bglasford1/AgcBlockIIComputer/schematics/DSKY/README.md

The DSKY sub-system consists of the Keyboard, Display and IMI Interface modules. The following schematic sheets are used.

DSKY_IMI : The DSKY Interface module

DSKY_KBD : The Keyboard module

DSKY_TEST : Simple test module

DSKY_DSP : The Display module

    DSKY_DSP_CHN : Contains I/O channel registers
    
    DSKY_DSP_REGCTL : Converts channel bits 12-15 into discrete signals 

    DSKY_DSP_DCD : Contains display code converters

    DSKY_DSP_IND : Contains indicator lights logic

    DSKY_DSP_CTL : Contains display control logic

    DSKY_DSP_REG : Contains display registers
    
    DSKY_DSP_SIGN : Contains decode logic for the sign LEDs

    DSKY_DSP_DRV : Contains the LED driver chips
    
    DSKY_DSP_LCD : Contains the 7-segment LEDs
