bglasford1/AgcBlockIIComputer/schematics/DISP/README.md

The Display (DISP) sub-system consists of the Monitor and Display Interface modules. The following schematic sheets are used.

DISP_DMI : The Display Interface Module

DISP_MON : The Monitor Module

    DISP_MON_DCD : Contains the sub-sequence decoding logic

    DISP_MON_SWT : Contains the switches
    
    DISP_MON_SWB : Contains the switch bank (16 input switches)
    
    DISP_MON_LEDs : Contains the LEDs
