bglasford1/AgcBlockIIComputer/schematics/CTL/README.md

The Control (CTL) sub-system consists of the Clock, Scalar, Timing Pulse Generator, Sequence Generator, Control Pulse Matrix and CTL Interface modules.  The following schematic sheets are used.

CTL_CLK : The Clock Module

CTL_SCL : The Scalar Module

CTL_TPG : The Timing Pulse Generator Module

CTL_CMI : The Control Interface Module

CTL_CPM-A : The A portion of the Control Pulse Matrix Module

CTL_CPM-B : The B portion of the Control Pulse Matrix Module

CTL_CPM-C : The C portion of the Control Pulse Matrix Module

CTL_SEQ : The Sequence Generator Module

    CTL_SEQ_SEQA : Contains the stage and branch registers

    CTL_SEQ_SEQB : Contains the sequence register

    CTL_SEQ_DCD : Contains the sub-sequence decode logic

    CTL_SEQ_CTL : Contains various control signal generation logic
