bglasford1/AgcBlockIIComputer/schematics/PROC/README.md

The Processor (PROC) sub-system consists of the Central Registers, Arithmetic Logic Unit and PROC Interface modules. The following schematic sheets are used.

PROC_PMI : The Processor Interface Module

PROC_CRG : The Central Registers Module

    PROC_CRG_WCHN : Contains the write channel logic
    
    PROC_CRG_RCHN : Contains the read channel logic
    
    PROC_CRG_AREG : Contains the A register logic
    
    PROC_CRG_LREG : Contains the L register logic
    
    PROC_CRG_QREG : Contains the Q register logic
    
    PROC_CRG_ZREG :  Contains the Z register logic
    
PROC_ALU : The Arithmetic Logic Unit Module

    PROC_ALU_X : Contains the X register logic
    
    PROC_ALU_Y : Contains the Y register logic
    
    PROC_ALU_ADD : Contains the X/Y adder
    
    PROC_ALU_B : Contains the B register logic
    
    PROC_ALU_ALU : Contains the ALU logic
    
    PROXC_ALU_VAL : Contains write bus ORing logic
