bglasford1/AgcBlockIIComputer/Tester/README.md

The tester programs run on either an Arduino or Raspberry Pi.  The Arduino programs have a .ino extension whereas the Raspberry pi programs are .py python programs.
