bglasford1/AgcBlockIIComputer/(threads)

Thread 1 (2021-09-28):

Flashing Noun/Verb

bglasford1, 2021-09-28:
Flash the Noun/Verb values instead of the indicator light.

bglasford1, 2021-11-16:
Updated DSKY to remove the 3 LED display driver chips and replace with simpler chips, allowing for this capability.

Closed 2021-11-16.
