bglasford1/AgcBlockIIComputer/schematics/CTL/CTL_CLK.sch

## KiCad design schematics/CTL/CTL_CLK.sch (2022-07-07)

Schematic: CTL_CLK.sch

Parts:
C1, C2: 20pF
C3: 470uF
R1: 1K
R22: 5.1k
R23: 47k
R24: 6.8k
R27: 10m
R28: 22k
R29, R30: 2.2K
U1: 74LS112
U55, U65: 74LS04
U57, U58: 74LS00
U59: 4001
U60: 74LS02
U61: 74LS32
U126: 74LS08
Y1: 4 MHz XTAL

Notes on the sheet:
Clock Step
2 MHz Clock: or slow variable rate clock FCLK = 1 : free running FCLK = 2 : stepped
Clock: 4 MHz
Four Phase Non-overlapping 1 MHz Clock
1 MHz
Slow
Selects between a fast, fixed rate clock and a slow variable rate clock.
CTL-CLK: Clock Module Copyright 2021, William Glasford
Clock Ctrl
Clock Mode
Active Low
Master Reset Switch
FFA
FFB
CLK4
Clock Rate
