bglasford1/AgcBlockIIComputer/schematics/CTL/CTL_CMI.sch

## KiCad design schematics/CTL/CTL_CMI.sch (2022-07-07)

Schematic: CTL_CMI.sch

Parts:
J100, J106: Conn_02x20
J101, J103, J107: Conn_02x08
J102, J104: Conn_02x10
J203, J204: Backplane

Notes on the sheet:
To PROC
To MEM
To I/O
Write Bus
Channel Bus
CTL-CMI: Interface Copyright 2021, William Glasford
