bglasford1/AgcBlockIIComputer/schematics/CTL/CTL_CPM-A.sch

## KiCad design schematics/CTL/CTL_CPM-A.sch (2022-07-07)

Schematic: CTL_CPM-A.sch

Parts:
U14, U15, U16, U17, U18, U19, U20, U21, U22: 27C512; DIP-28_W15.24mm
U23, U24: 74LS244
U56, U74: 74LS04
U61: 74LS32
U75, U76: 74LS08
U77: 74LS20
U78: 74LS10

Notes on the sheet:
Control Pulse Matrix EPROMs: 1’s compliement logic.
EPROM 1-8
EPROM 17-24
EPROM 25-32
EPROM 33-40
EPROM 41-48
EPROM 49-56
EPROM 57-64
EPROM 9-16
EPROM 65-72
EPROM Address Bus
Note: a signal followed by an “a” means this is a partial.
ZAP
CTL-CPM-A: CPM Part A Get Pulses from Matrix Copyright 2021, William Glasford
