bglasford1/AgcBlockIIComputer/schematics/CTL/CTL_CPM-B.sch

## KiCad design schematics/CTL/CTL_CPM-B.sch (2022-07-07)

Schematic: CTL_CPM-B.sch

Parts:
U25, U26, U27, U28, U35: 74LS138
U29, U30, U33, U34: 74LS244
U31, U32: 74LS154
U80, U84, U228: 74LS11
U81, U82, U83: 74LS08
U117, U229: 74LS04

Notes on the sheet:
Write the Super-Bank Value
CTL-CPM-B : CPM Part B Expand pulses from Part A Copyright 2021, William Glasford
TODO: The DISP, INDC and RPRO may be connected to the wrong commands; RCH, WCH
