bglasford1/AgcBlockIIComputer/schematics/CTL/CTL_CPM-C.sch

## KiCad design schematics/CTL/CTL_CPM-C.sch (2022-07-07)

Schematic: CTL_CPM-C.sch

Parts:
U36: 74LS154
U37: 74LS74
U61, U86, U87, U89, U90, U122: 74LS32
U83, U88, U97, U98: 74LS08
U85: 74LS04
U91: 74LS10
U109, U125: 74LS00

Notes on the sheet:
TP12
TP11
TP6
TP4
TP7
TP10
TP1
TP3
CLREXT Register
PWR-ON
CTL-CPM-C: CPM Part C Memory Cycle Pulses Copyright 2021, William Glasford
