bglasford1/AgcBlockIIComputer/schematics/CTL/CTL_SCL.sch

## KiCad design schematics/CTL/CTL_SCL.sch (2022-07-07)

Schematic: CTL_SCL.sch

Parts:
U2, U3, U4, U5, U6, U7: 74LS161
U8, U9, U10: 74LS112
U62: 74LS04
U63: 74LS00
U64: 74LS02

Notes on the sheet:
F10
F11
F12
F13
F14
F15
F16
F17
100 Hz
12.5 Hz
0.78125 Hz
CTL-SCL: Scalar Module Copyright 2021, William Glasford
Scalar Enable
Inverted CLK1
51.2 kHz
