bglasford1/AgcBlockIIComputer/schematics/CTL/CTL_SEQ_CTL.sch

## KiCad design schematics/CTL/CTL_SEQ_CTL.sch (2022-07-07)

Schematic: CTL_SEQ_CTL.sch

Parts:
U74, U104, U117, U186: 74LS04
U78: 74LS10
U109: 74LS00
U111: 74LS02
U118, U119, U120, U121, U202: 74LS11
U122: 74LS32
U123, U204: 74LS21
U127: 74LS20
U201: 74LS27

Notes on the sheet:
CTL-SEQ-CTL: Control Logic Copyright 2021, William Glasford
