bglasford1/AgcBlockIIComputer/schematics/CTL/CTL_SEQ_DCD.sch

## KiCad design schematics/CTL/CTL_SEQ_DCD.sch (2022-07-07)

Schematic: CTL_SEQ_DCD.sch

Parts:
U61: 74LS32
U72, U116: 74LS11
U76, U113, U114: 74LS08
U110, U186: 74LS04
U111: 74LS02
U112: 74LS27
U115: 74LS00
U188, U189: 74LS244
U190: 27C128; DIP-28_W15.24mm
U191, U192, U193, U194: 74LS154

Notes on the sheet:
Sub-Sequence Bus
Sub-Sequence EPROM
CTL-SEQ-DCD: Sequence Decoding Logic Copyright 2021, William Glasford
Note: The output of these instruction indications is negative logic.
