bglasford1/AgcBlockIIComputer/schematics/CTL/CTL_SEQ_SEQA.sch

## KiCad design schematics/CTL/CTL_SEQ_SEQA.sch (2022-07-07)

Schematic: CTL_SEQ_SEQA.sch

Parts:
U38, U39, U40, U41: 74LS74
U60: 74LS02
U73: 74LS27
U85, U92, U93, U102: 74LS04
U94, U95, U96, U97, U98: 74LS08
U99, U100: 74LS32
U101: 74LS21

Notes on the sheet:
PST1 Reg
STG1 Reg
STG2 Reg
STG3 Reg
BR1 Reg
BR2 Reg
PST2 Reg
PST3 Reg
CTL-SEQ-SEQA: Stage & Branch Registers Copyright 2021, William Glasford
