bglasford1/AgcBlockIIComputer/schematics/CTL/CTL_SEQ_SEQB.sch

## KiCad design schematics/CTL/CTL_SEQ_SEQB.sch (2022-07-07)

Schematic: CTL_SEQ_SEQB.sch

Parts:
U42, U43, U44, U45: 74LS244
U46: 74LS273
U47: 74LS112
U56, U102, U103, U104: 74LS04
U58, U109: 74LS00
U64: 74LS02
U98: 74LS08
U105, U106: 74LS20
U107: 74LS10
U108: 74LS126

Notes on the sheet:
SEQ Register
Check for all 1s.
SNI Reg
CTL-SEQ-SEQB: SEQ Register Copyright 2021, William Glasford
