bglasford1/AgcBlockIIComputer/schematics/CTL/CTL_TPG.sch

## KiCad design schematics/CTL/CTL_TPG.sch (2022-07-07)

Schematic: CTL_TPG.sch

Parts:
U12: 74LS161
U13: 74LS154
U56, U65: 74LS04
U60, U67: 74LS02
U66: 74LS00
U68, U69, U70: 74LS08
U72: 74LS11
U73: 74LS27
U108: 74LS126
U122: 74LS32

Notes on the sheet:
TPG Decoded Bus
CET
NPE
CTL-TPG: Timing Pulse Generator Copyright 2021, William Glasford
TPG Bus
Internal TPG Bus
Breakpoint Enabled
Counter Breakpoint Enabled
Interrupt Breakpoint Enabled
Exec. Mode
Execute Control
Exec. Step
Clock Mode
Standby
STBY
PWON
SRLSE
WAIT
TP12
