bglasford1/AgcBlockIIComputer/schematics/DISP/DISP_DMI.sch

## KiCad design schematics/DISP/DISP_DMI.sch (2021-08-23)

Schematic: DISP_DMI.sch

Parts:
J101: Conn_02x08
J104: Conn_02x10
J200, J201: Conn_01x40_Male

Notes on the sheet:
Switches:
Inputs: Note that very few are shown.
DISP_DMI: Interface Copyright 2021, William Glasford
Channel Bus
Write Bus
