bglasford1/AgcBlockIIComputer/schematics/DISP/DISP_MON_DCD.sch

## KiCad design schematics/DISP/DISP_MON_DCD.sch (2021-08-23)

Schematic: DISP_MON_DCD.sch

Parts:
C1, C3: .01uF
C2: 22uF
C4: 2.2uF
R86, R89: 10k
R87: 330
R88: 1k
R90: 33k
R91: 5.6k
U5, U6: LM555; SOIC-8_3.9x4.9mm_P1.27mm
U186: 74LS04
U191, U192, U193, U194: 74LS154
U206: 74LS00

Notes on the sheet:
Sub-Sequence Bus
DISP_MON_DCD: Sequence Decoding Logic Copyright 2021, William Glasford
Switch Debounce
Variable Clock Rate Dial
Clock Rate
