bglasford1/AgcBlockIIComputer/schematics/DISP/DISP_MON_SWB.sch

## KiCad design schematics/DISP/DISP_MON_SWB.sch (2021-08-11)

Schematic: DISP_MON_SWB.sch

Parts:
R1, R2, R3, R4, R5, R6, R7, R8, R9, R10, R11, R12, R13, R14, R15, R16: 1k
SW1, SW2, SW3, SW4, SW5, SW6, SW7, SW8, SW9, SW10, SW11, SW12, SW13, SW14, SW15, SW16: SW_SPDT

Notes on the sheet:
DISP_MON_SWB: Switch Bank Copyright 2021, William Glasford
