bglasford1/AgcBlockIIComputer/schematics/DISP/DISP_MON_SWT.sch

## KiCad design schematics/DISP/DISP_MON_SWT.sch (2021-08-23)

Schematic: DISP_MON_SWT.sch

Parts:
D105: LED
R17, R18, R19, R20, R21, R74, R75, R76, R77, R78, R79, R81, R82, R83, R84, R85: 1k
R80: 5.6k
R123: 470 Ohm
SW17, SW18, SW19, SW20, SW21, SW22, SW23, SW26, SW27, SW28, SW29, SW30, SW36, SW39, SW41: SW_Push
SW24, SW25, SW32, SW33, SW34, SW35, SW38, SW40: SW_SPDT
SW31, SW37: SW_Push_SPDT
U8: 74LS04
U9, U10, U11: 74LS112

Notes on the sheet:
Exec Step
Clock Step
Clock Mode (Run/Step)
SCALAR ENABLE
Enable
Disable
Exec Control
Exec Mode (Run/Step)
Breakpoint Enabled
DISP_MON_SWT: Monitor Switches Copyright 2021, William Glasford
RUPT3
RUPT4
Inc. Time1
Inc. Time3
Inc. Time4
Examine Next
Memory Read/Write
Load Memory
Examine Memory
Memory Authority
Manual
AGC
Clear Parity Alarm
Write
Read
Clock Control
Slow
1 MHz
F17x Signal
F13x Signal
F10x Signal
Master Reset
Inc. Time2
RUPT5
