bglasford1/AgcBlockIIComputer/schematics/DSKY/DSKY-DSP-CHN.sch

## KiCad design schematics/DSKY/DSKY-DSP-CHN.sch (2022-04-18)

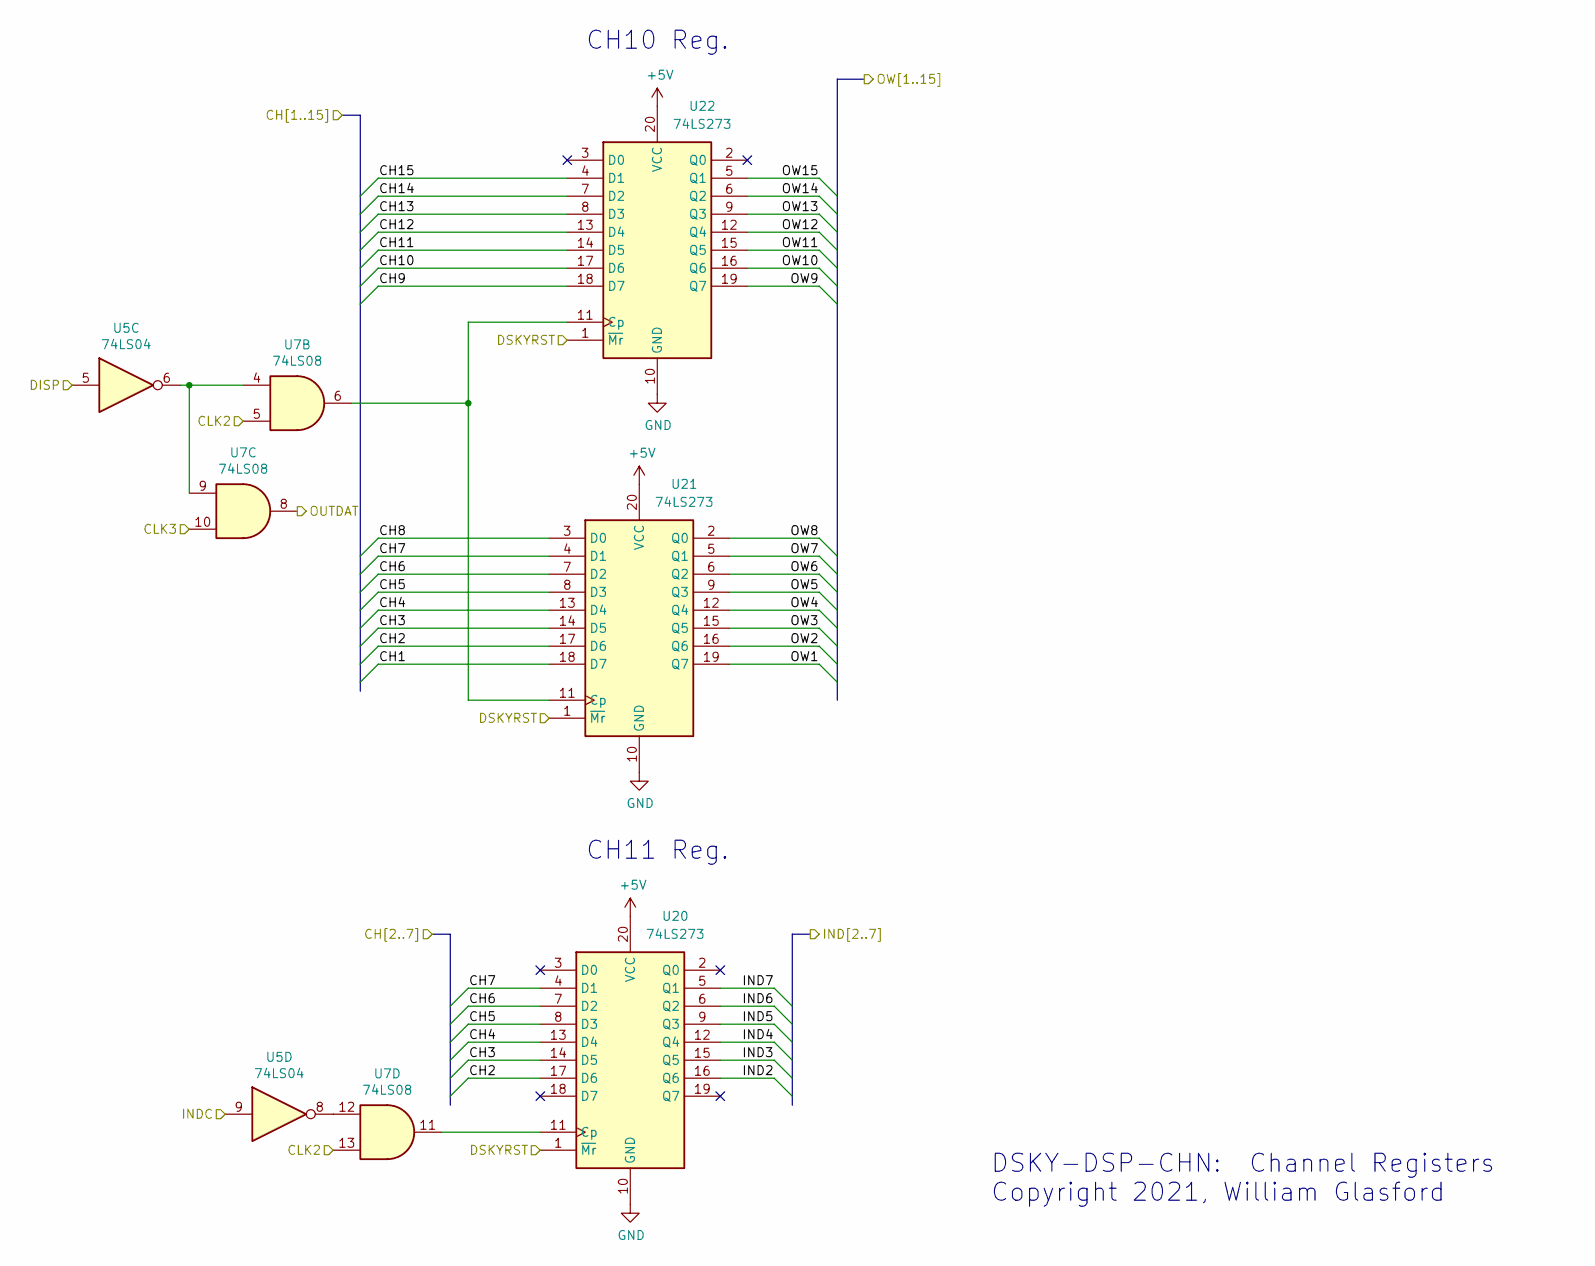
[picture p2: schematic DSKY-DSP-CHN.sch]

Parts:
U5: 74LS04
U7: 74LS08
U20, U21, U22: 74LS273

Connections:
+5V: U20.20 (VCC), U21.20 (VCC), U22.20 (VCC)
CH1: U21.18 (D7)
CH2: U20.17 (D6), U21.17 (D6)
CH3: U20.14 (D5), U21.14 (D5)
CH4: U20.13 (D4), U21.13 (D4)
CH5: U20.8 (D3), U21.8 (D3)
CH6: U20.7 (D2), U21.7 (D2)
CH7: U20.4 (D1), U21.4 (D1)
CH8: U21.3 (D0)
CH9: U22.18 (D7)
CH10: U22.17 (D6)
CH11: U22.14 (D5)
CH12: U22.13 (D4)
CH13: U22.8 (D3)
CH14: U22.7 (D2)
CH15: U22.4 (D1)
CLK2: U7.5, U7.13
CLK3: U7.10
DISP: U5.5
DSKYRST: U20.1 (~Mr), U21.1 (~Mr), U22.1 (~Mr)
GND: U20.10 (GND), U21.10 (GND), U22.10 (GND)
IND2: U20.16 (Q6)
IND3: U20.15 (Q5)
IND4: U20.12 (Q4)
IND5: U20.9 (Q3)
IND6: U20.6 (Q2)
IND7: U20.5 (Q1)
INDC: U5.9
unnamed: U5.6, U7.4, U7.9
unnamed: U5.8, U7.12
unnamed: U7.11, U20.11 (Cp)
unnamed: U7.6, U21.11 (Cp), U22.11 (Cp)
OUTDAT: U7.8
OW1: U21.19 (Q7)
OW2: U21.16 (Q6)
OW3: U21.15 (Q5)
OW4: U21.12 (Q4)
OW5: U21.9 (Q3)
OW6: U21.6 (Q2)
OW7: U21.5 (Q1)
OW8: U21.2 (Q0)
OW9: U22.19 (Q7)
OW10: U22.16 (Q6)
OW11: U22.15 (Q5)
OW12: U22.12 (Q4)
OW13: U22.9 (Q3)
OW14: U22.6 (Q2)
OW15: U22.5 (Q1)

Notes on the sheet:
CH10 Reg.
CH11 Reg.
DSKY-DSP-CHN: Channel Registers Copyright 2021, William Glasford
