bglasford1/AgcBlockIIComputer/schematics/DSKY/DSKY-DSP-REGCTL.sch

## KiCad design schematics/DSKY/DSKY-DSP-REGCTL.sch (2022-04-18)

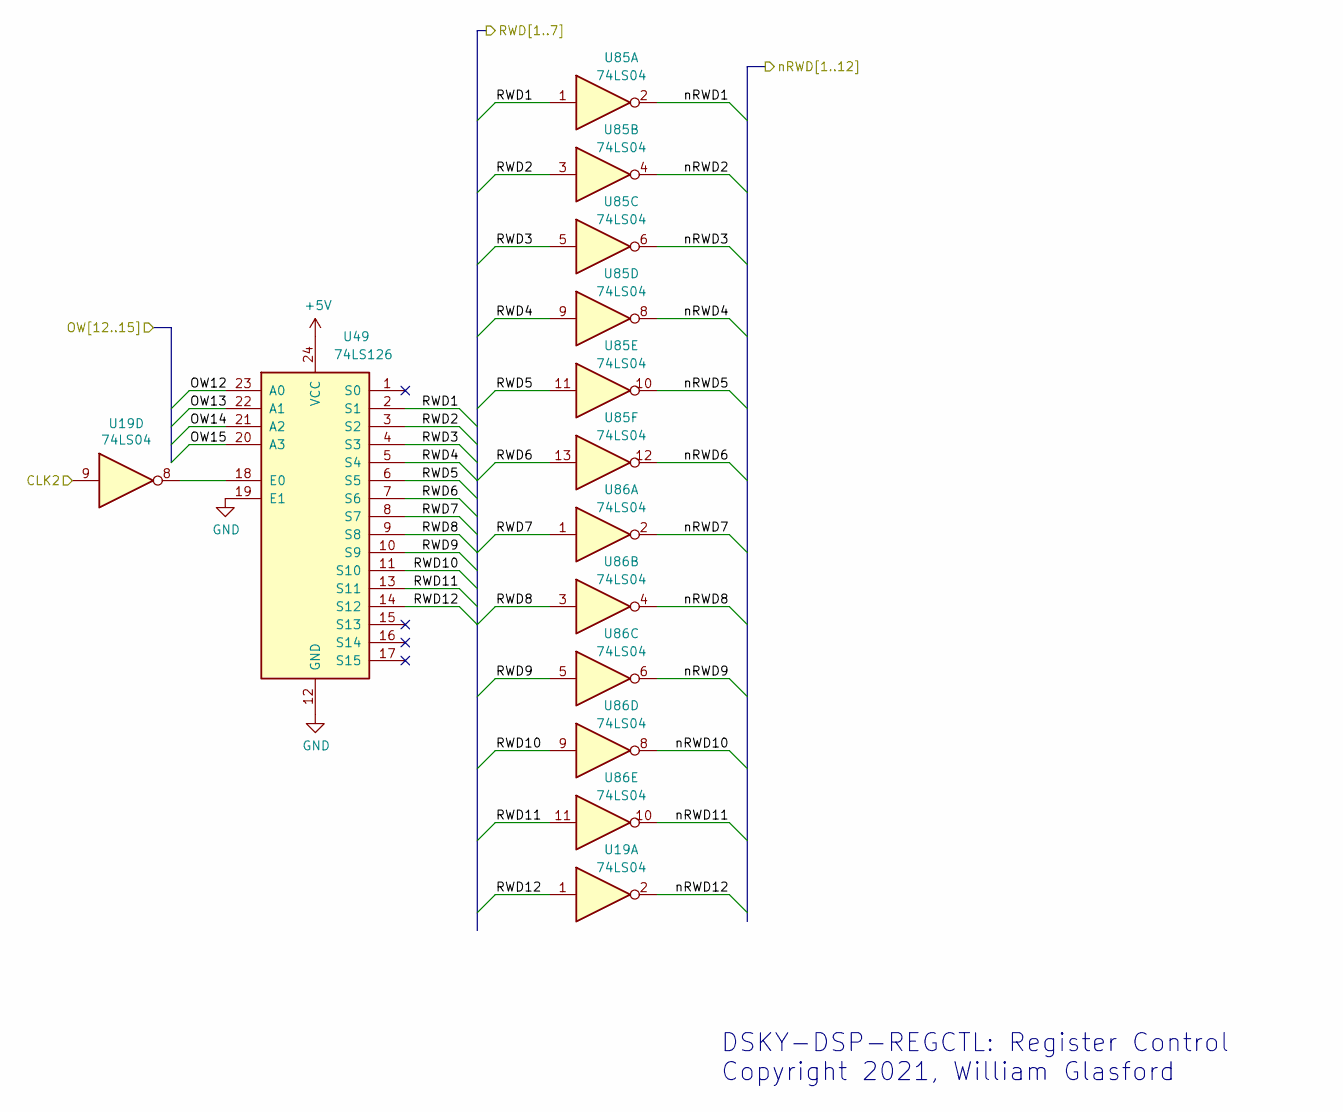
[picture p3: schematic DSKY-DSP-REGCTL.sch]

Parts:
U19, U85, U86: 74LS04
U49: 74LS126

Connections:
+5V: U49.24 (VCC)
CLK2: U19.9
GND: U49.12 (GND), U49.19 (E1)
unnamed: U19.8, U49.18 (E0)
OW12: U49.23 (A0)
OW13: U49.22 (A1)
OW14: U49.21 (A2)
OW15: U49.20 (A3)
RWD1: U49.2 (S1), U85.1
RWD2: U49.3 (S2), U85.3
RWD3: U49.4 (S3), U85.5
RWD4: U49.5 (S4), U85.9
RWD5: U49.6 (S5), U85.11
RWD6: U49.7 (S6), U85.13
RWD7: U49.8 (S7), U86.1
RWD8: U49.9 (S8), U86.3
RWD9: U49.10 (S9), U86.5
RWD10: U49.11 (S10), U86.9
RWD11: U49.13 (S11), U86.11
RWD12: U19.1, U49.14 (S12)
nRWD1: U85.2
nRWD2: U85.4
nRWD3: U85.6
nRWD4: U85.8
nRWD5: U85.10
nRWD6: U85.12
nRWD7: U86.2
nRWD8: U86.4
nRWD9: U86.6
nRWD10: U86.8
nRWD11: U86.10
nRWD12: U19.2

Notes on the sheet:
DSKY-DSP-REGCTL: Register Control Copyright 2021, William Glasford
