bglasford1/AgcBlockIIComputer/schematics/DSKY/DSKY-DSP-SIGN.sch

## KiCad design schematics/DSKY/DSKY-DSP-SIGN.sch (2022-04-18)

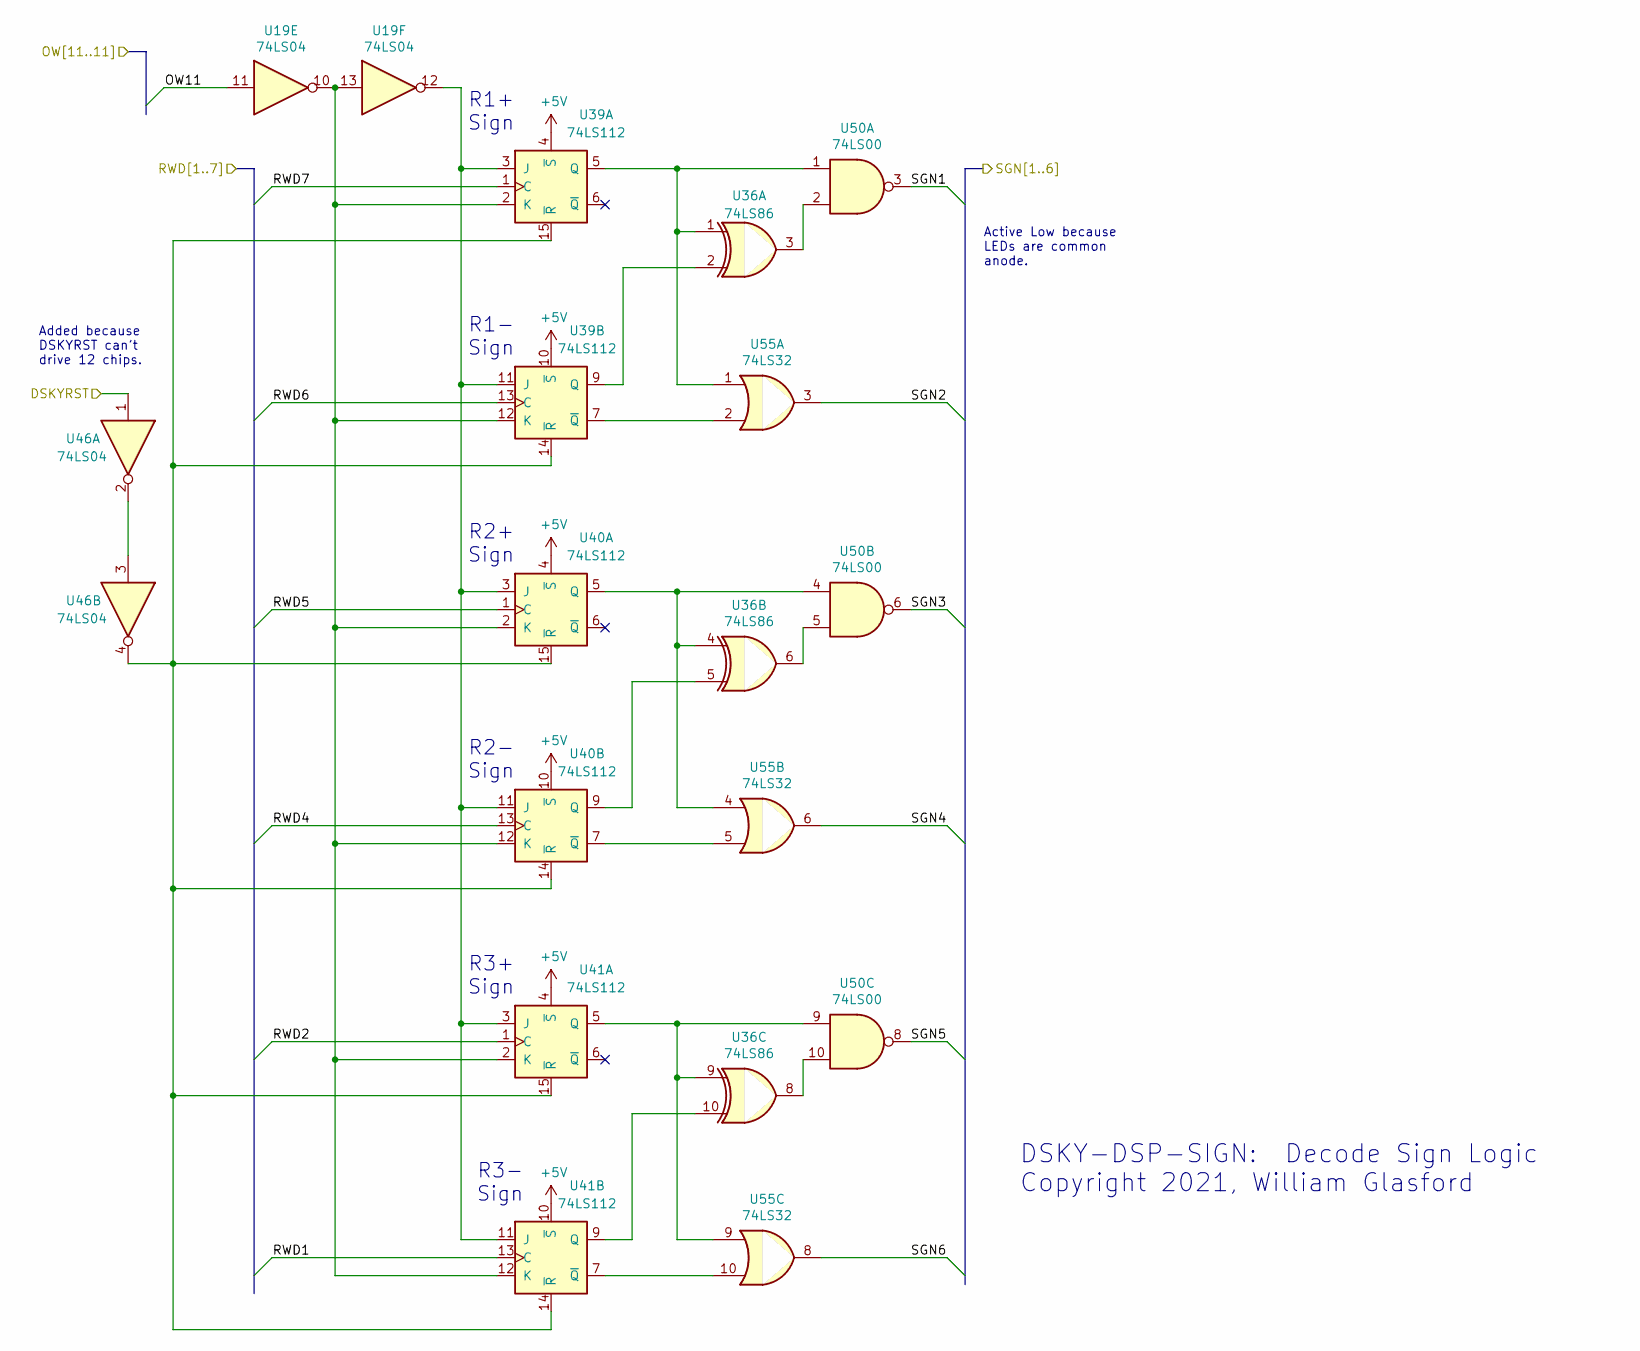
[picture p4: schematic DSKY-DSP-SIGN.sch]

Parts:
U19, U46: 74LS04
U36: 74LS86
U39, U40, U41: 74LS112
U50: 74LS00
U55: 74LS32

Connections:
+5V: U39.4 (~S), U39.10 (~S), U40.4 (~S), U40.10 (~S), U41.4 (~S), U41.10 (~S)
DSKYRST: U46.1
unnamed: U19.10, U19.13, U39.2 (K), U39.12 (K), U40.2 (K), U40.12 (K), U41.2 (K), U41.12 (K)
unnamed: U19.12, U39.3 (J), U39.11 (J), U40.3 (J), U40.11 (J), U41.3 (J), U41.11 (J)
unnamed: U36.1, U39.5 (Q), U50.1, U55.1
unnamed: U36.2, U39.9 (Q)
unnamed: U36.3, U50.2
unnamed: U36.4, U40.5 (Q), U50.4, U55.4
unnamed: U36.5, U40.9 (Q)
unnamed: U36.6, U50.5
unnamed: U36.8, U50.10
unnamed: U36.9, U41.5 (Q), U50.9, U55.9
unnamed: U36.10, U41.9 (Q)
unnamed: U39.7 (~Q), U55.2
unnamed: U39.14 (~R), U39.15 (~R), U40.14 (~R), U40.15 (~R), U41.14 (~R), U41.15 (~R), U46.4
unnamed: U40.7 (~Q), U55.5
unnamed: U41.7 (~Q), U55.10
unnamed: U46.2, U46.3
OW11: U19.11
RWD1: U41.13 (C)
RWD2: U41.1 (C)
RWD4: U40.13 (C)
RWD5: U40.1 (C)
RWD6: U39.13 (C)
RWD7: U39.1 (C)
SGN1: U50.3
SGN2: U55.3
SGN3: U50.6
SGN4: U55.6
SGN5: U50.8
SGN6: U55.8

Notes on the sheet:
DSKY-DSP-SIGN: Decode Sign Logic Copyright 2021, William Glasford
R1+ Sign
R1- Sign
R2+ Sign
R2- Sign
R3+ Sign
R3- Sign
Added because DSKYRST can’t drive 12 chips.
Active Low because LEDs are common anode.
