bglasford1/AgcBlockIIComputer/schematics/DSKY/DSKY-IMI.sch

## KiCad design schematics/DSKY/DSKY-IMI.sch (2022-04-18)

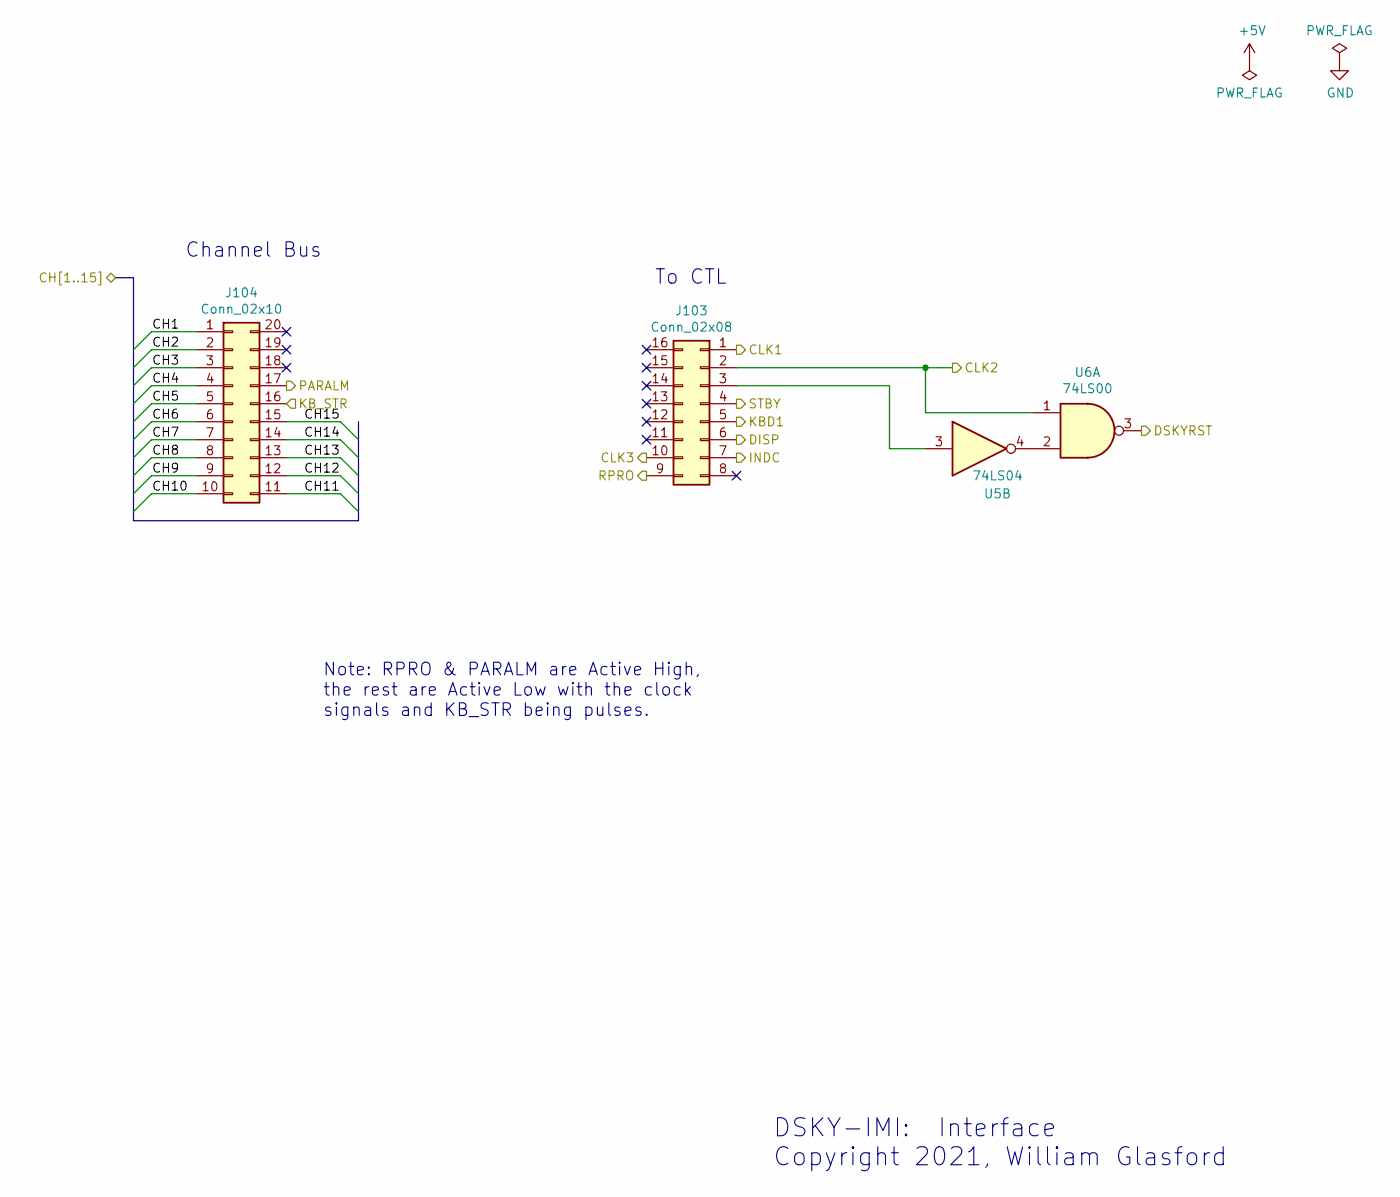
[picture p5: schematic DSKY-IMI.sch]

Parts:
J103: Conn_02x08
J104: Conn_02x10
U5: 74LS04
U6: 74LS00

Connections:
CH1: J104.1
CH2: J104.2
CH3: J104.3
CH4: J104.4
CH5: J104.5
CH6: J104.6
CH7: J104.7
CH8: J104.8
CH9: J104.9
CH10: J104.10
CH11: J104.11
CH12: J104.12
CH13: J104.13
CH14: J104.14
CH15: J104.15
CLK1: J103.1
CLK2: J103.2, U6.1
CLK3: J103.10
DISP: J103.6
DSKYRST: U6.3
INDC: J103.7
KBD1: J103.5
KB_STR: J104.16
unnamed: J103.3, U5.3
unnamed: U5.4, U6.2
PARALM: J104.17
RPRO: J103.9
STBY: J103.4

Notes on the sheet:
Channel Bus
To CTL
DSKY-IMI: Interface Copyright 2021, William Glasford
Note: RPRO & PARALM are Active High, the rest are Active Low with the clock signals and KB_STR being pulses.
