bglasford1/AgcBlockIIComputer/schematics/DSKY/DSKY-KBD.sch

## KiCad design schematics/DSKY/DSKY-KBD.sch (2022-04-18)

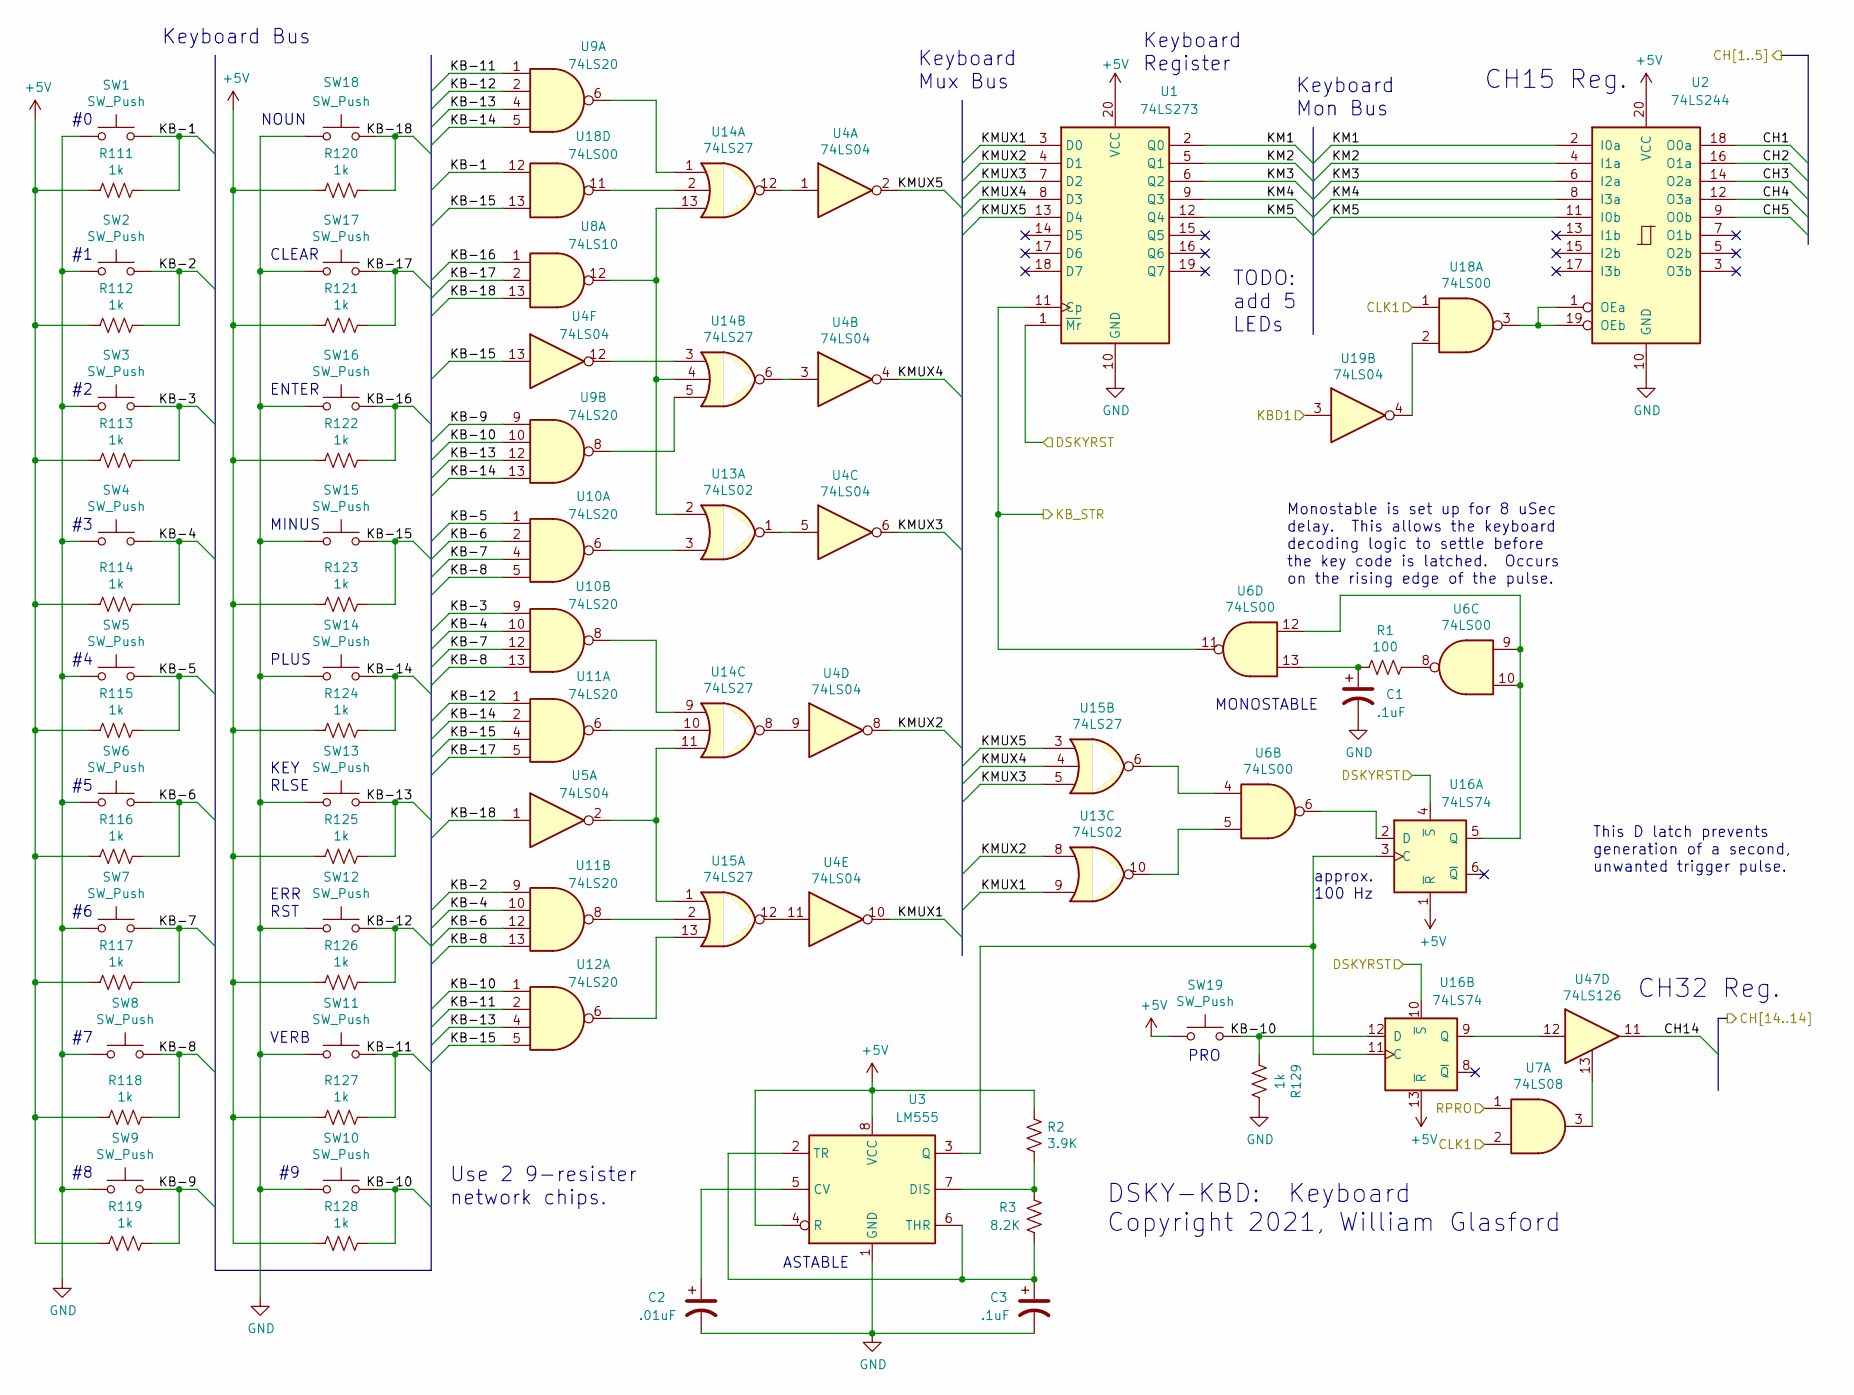
[picture p6: schematic DSKY-KBD.sch]

Parts:
C1, C3: .1uF
C2: .01uF
R1: 100
R2: 3.9K
R3: 8.2K
R111, R112, R113, R114, R115, R116, R117, R118, R119, R120, R121, R122, R123, R124, R125, R126, R127, R128, R129: 1k
SW1, SW2, SW3, SW4, SW5, SW6, SW7, SW8, SW9, SW10, SW11, SW12, SW13, SW14, SW15, SW16, SW17, SW18, SW19: SW_Push
U1: 74LS273
U2: 74LS244
U3: LM555; DIP-8_W7.62mm
U4, U5, U19: 74LS04
U6, U18: 74LS00
U7: 74LS08
U8: 74LS10
U9, U10, U11, U12: 74LS20
U13: 74LS02
U14, U15: 74LS27
U16: 74LS74
U47: 74LS126

Connections:
+5V: R2.1, R111.1, R112.1, R113.1, R114.1, R115.1, R116.1, R117.1, R118.1, R119.1, R120.1, R121.1, R122.1, R123.1, R124.1, R125.1, R126.1, R127.1, R128.1, SW19.1, U1.20 (VCC), U2.20 (VCC), U3.4 (R), U3.8 (VCC), U16.1 (~R), U16.13 (~R)
CH1: U2.18 (O0a)
CH2: U2.16 (O1a)
CH3: U2.14 (O2a)
CH4: U2.12 (O3a)
CH5: U2.9 (O0b)
CH14: U47.11
CLK1: U7.2, U18.1
DSKYRST: U1.1 (~Mr), U16.4 (~S), U16.10 (~S)
GND: C1.2, C2.2, C3.2, R129.2, SW1.1, SW2.1, SW3.1, SW4.1, SW5.1, SW6.1, SW7.1, SW8.1, SW9.1, SW10.1, SW11.1, SW12.1, SW13.1, SW14.1, SW15.1, SW16.1, SW17.1, SW18.1, U1.10 (GND), U2.10 (GND), U3.1 (GND)
KB-1: R111.2, SW1.2, U18.12
KB-2: R112.2, SW2.2, U11.9
KB-3: R113.2, SW3.2, U10.9
KB-4: R114.2, SW4.2, U10.10, U11.10
KB-5: R115.2, SW5.2, U10.1
KB-6: R116.2, SW6.2, U10.2, U11.12
KB-7: R117.2, SW7.2, U10.4, U10.12
KB-8: R118.2, SW8.2, U10.5, U10.13, U11.13
KB-9: R119.2, SW9.2, U9.9
KB-10: R128.2, R129.1, SW10.2, SW19.2, U9.10, U12.1, U16.12 (D)
KB-11: R127.2, SW11.2, U9.1, U12.2
KB-12: R126.2, SW12.2, U9.2, U11.1
KB-13: R125.2, SW13.2, U9.4, U9.12, U12.4
KB-14: R124.2, SW14.2, U9.5, U9.13, U11.2
KB-15: R123.2, SW15.2, U4.13, U11.4, U12.5, U18.13
KB-16: R122.2, SW16.2, U8.1
KB-17: R121.2, SW17.2, U8.2, U11.5
KB-18: R120.2, SW18.2, U5.1, U8.13
KBD1: U19.3
KB_STR: U1.11 (Cp), U6.11
KM1: U1.2 (Q0), U2.2 (I0a)
KM2: U1.5 (Q1), U2.4 (I1a)
KM3: U1.6 (Q2), U2.6 (I2a)
KM4: U1.9 (Q3), U2.8 (I3a)
KM5: U1.12 (Q4), U2.11 (I0b)
KMUX1: U1.3 (D0), U4.10, U13.9
KMUX2: U1.4 (D1), U4.8, U13.8
KMUX3: U1.7 (D2), U4.6, U15.5
KMUX4: U1.8 (D3), U4.4, U15.4
KMUX5: U1.13 (D4), U4.2, U15.3
unnamed: C1.1, R1.1, U6.13
unnamed: C2.1, U3.5 (CV)
unnamed: C3.1, R3.2, U3.2 (TR), U3.6 (THR)
unnamed: R1.2, U6.8
unnamed: R2.2, R3.1, U3.7 (DIS)
unnamed: U10.6, U13.3
unnamed: U10.8, U14.9
unnamed: U11.6, U14.10
unnamed: U11.8, U15.2
unnamed: U12.6, U15.13
unnamed: U4.5, U13.1
unnamed: U8.12, U13.2, U14.4, U14.13
unnamed: U6.5, U13.10
unnamed: U9.6, U14.1
unnamed: U14.2, U18.11
unnamed: U4.12, U14.3
unnamed: U9.8, U14.5
unnamed: U4.3, U14.6
unnamed: U4.9, U14.8
unnamed: U5.2, U14.11, U15.1
unnamed: U4.1, U14.12
unnamed: U6.4, U15.6
unnamed: U4.11, U15.12
unnamed: U6.6, U16.2 (D)
unnamed: U6.9, U6.10, U6.12, U16.5 (Q)
unnamed: U16.9 (Q), U47.12
unnamed: U3.3 (Q), U16.3 (C), U16.11 (C)
unnamed: U18.2, U19.4
unnamed: U2.1 (OEa), U2.19 (OEb), U18.3
unnamed: U7.3, U47.13
RPRO: U7.1

Notes on the sheet:
Keyboard Bus
Keyboard Mux Bus
Keyboard Register
NOUN
CLEAR
ENTER
MINUS
PLUS
KEY RLSE
ERR RST
VERB
This D latch prevents generation of a second, unwanted trigger pulse.
ASTABLE
approx. 100 Hz
MONOSTABLE
Monostable is set up for 8 uSec delay. This allows the keyboard decoding logic to settle before the key code is latched. Occurs on the rising edge of the pulse.
CH15 Reg.
Keyboard Mon Bus
TODO: add 5 LEDs
CH32 Reg.
DSKY-KBD: Keyboard Copyright 2021, William Glasford
Use 2 9-resister network chips.
PRO
