bglasford1/AgcBlockIIComputer/schematics/DSKY/DSKY-TEST.sch

## KiCad design schematics/DSKY/DSKY-TEST.sch (2022-04-18)

Schematic: DSKY-TEST.sch

Parts:
J203: Conn_02x08
J204: Conn_02x10
J300: RPI_Connector
U87, U88, U89, U90, U91: 74LS245

Notes on the sheet:
DSKY-TEST: Raspberry PI I/F Copyright 2021, William Glasford
