bglasford1/AgcBlockIIComputer/schematics/DSKY/DSKY_DSP_CTL.sch

## KiCad design schematics/DSKY/DSKY_DSP_CTL.sch (2022-04-18)

Schematic: DSKY_DSP_CTL.sch

Parts:
C4, C6: .01uF
C5: .001uF
C7: 22uF
R4: 3.3K
R5: 500K
R12: 27K
RV1: 10K
U17: 74LS04
U38, U75: 74LS74
U40, U41: LM555; DIP-8_W7.62mm
U48: 74LS00
U54, U81: 74LS08
U68, U80: 74LS112
U69: 74LS161
U70: 74LS154
U72: 74LS02
U73, U79: 74LS10
U74: 74LS244
U77: 74LS30
U78: 74LS27

Notes on the sheet:
2 Hz
2 KHz
DSKY-DSP-CTL: Display Control Copyright 2021, William Glasford Board #2
Mode/ Data
5th Digit: Delay one pulse off TC (1111)
State: 10000 Stop counting
Start State: 11110
State: 11111
Mode needs to be a single pulse before the write pulses to cause a read of the control data.
Write
Note: The NOR gates could be replaced by a NOT and OR gate. This was done to reduce the chip count.
