bglasford1/AgcBlockIIComputer/schematics/DSKY/DSKY_DSP_DCD.sch

## KiCad design schematics/DSKY/DSKY_DSP_DCD.sch (2022-04-18)

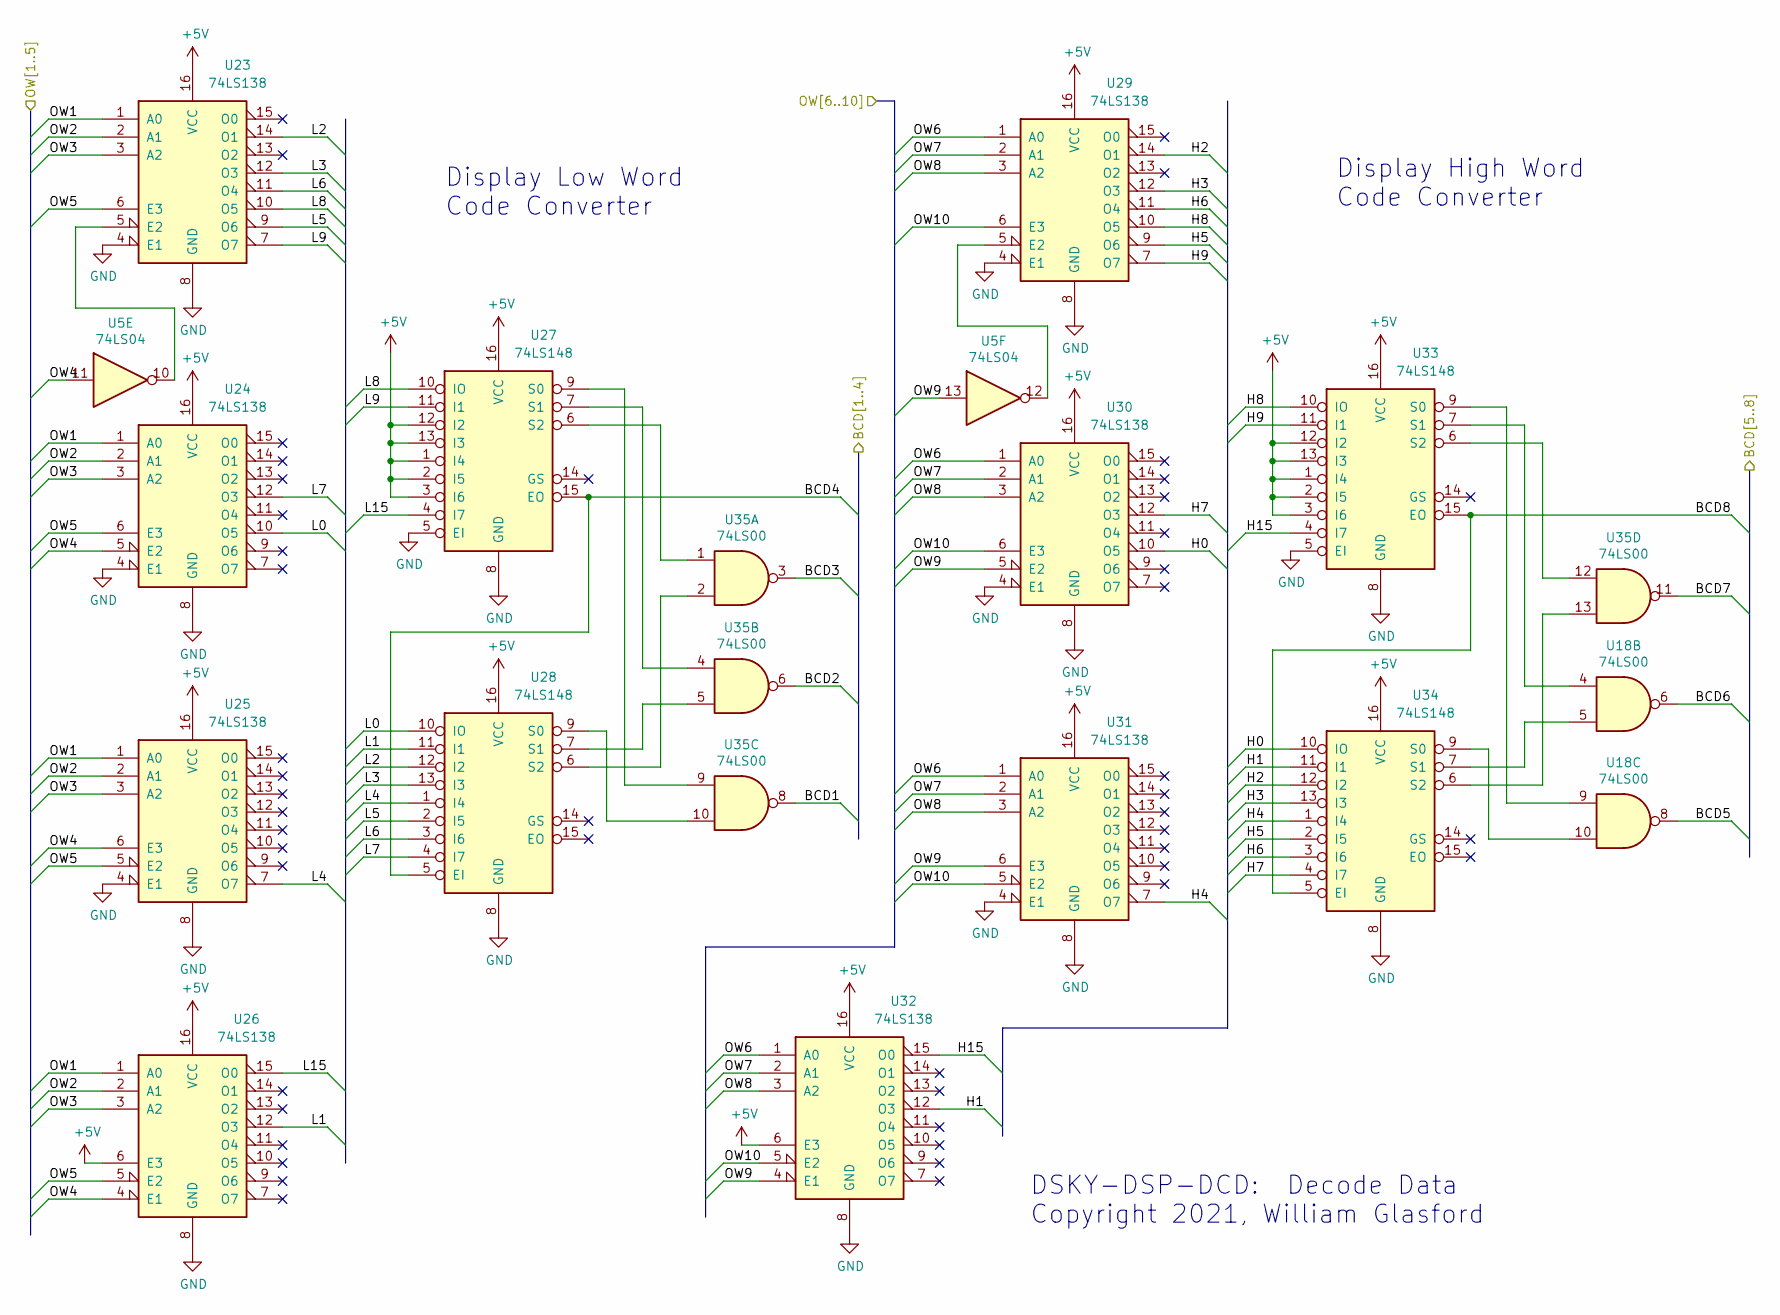
[picture p7: schematic DSKY_DSP_DCD.sch]

Parts:
U5: 74LS04
U18, U35: 74LS00
U23, U24, U25, U26, U29, U30, U31, U32: 74LS138
U27, U28, U33, U34: 74LS148

Connections:
+5V: U23.16 (VCC), U24.16 (VCC), U25.16 (VCC), U26.6 (E3), U26.16 (VCC), U27.1 (I4), U27.2 (I5), U27.3 (I6), U27.12 (I2), U27.13 (I3), U27.16 (VCC), U28.16 (VCC), U29.16 (VCC), U30.16 (VCC), U31.16 (VCC), U32.6 (E3), U32.16 (VCC), U33.1 (I4), U33.2 (I5), U33.3 (I6), U33.12 (I2), U33.13 (I3), U33.16 (VCC), U34.16 (VCC)
BCD1: U35.8
BCD2: U35.6
BCD3: U35.3
BCD4: U27.15 (EO), U28.5 (EI)
BCD5: U18.8
BCD6: U18.6
BCD7: U35.11
BCD8: U33.15 (EO), U34.5 (EI)
GND: U23.4 (E1), U23.8 (GND), U24.4 (E1), U24.8 (GND), U25.4 (E1), U25.8 (GND), U26.8 (GND), U27.5 (EI), U27.8 (GND), U28.8 (GND), U29.4 (E1), U29.8 (GND), U30.4 (E1), U30.8 (GND), U31.4 (E1), U31.8 (GND), U32.8 (GND), U33.5 (EI), U33.8 (GND), U34.8 (GND)
H0: U30.10 (O5), U34.10 (IO)
H1: U32.12 (O3), U34.11 (I1)
H2: U29.14 (O1), U34.12 (I2)
H3: U29.12 (O3), U34.13 (I3)
H4: U31.7 (O7), U34.1 (I4)
H5: U29.9 (O6), U34.2 (I5)
H6: U29.11 (O4), U34.3 (I6)
H7: U30.12 (O3), U34.4 (I7)
H8: U29.10 (O5), U33.10 (IO)
H9: U29.7 (O7), U33.11 (I1)
H15: U32.15 (O0), U33.4 (I7)
L0: U24.10 (O5), U28.10 (IO)
L1: U26.12 (O3), U28.11 (I1)
L2: U23.14 (O1), U28.12 (I2)
L3: U23.12 (O3), U28.13 (I3)
L4: U25.7 (O7), U28.1 (I4)
L5: U23.9 (O6), U28.2 (I5)
L6: U23.11 (O4), U28.3 (I6)
L7: U24.12 (O3), U28.4 (I7)
L8: U23.10 (O5), U27.10 (IO)
L9: U23.7 (O7), U27.11 (I1)
L15: U26.15 (O0), U27.4 (I7)
unnamed: U18.4, U33.7 (S1)
unnamed: U18.5, U34.7 (S1)
unnamed: U18.9, U33.9 (S0)
unnamed: U18.10, U34.9 (S0)
unnamed: U5.10, U23.5 (E2)
unnamed: U27.6 (S2), U35.1
unnamed: U27.7 (S1), U35.4
unnamed: U27.9 (S0), U35.9
unnamed: U28.6 (S2), U35.2
unnamed: U28.7 (S1), U35.5
unnamed: U28.9 (S0), U35.10
unnamed: U5.12, U29.5 (E2)
unnamed: U33.6 (S2), U35.12
unnamed: U34.6 (S2), U35.13
OW1: U23.1 (A0), U24.1 (A0), U25.1 (A0), U26.1 (A0)
OW2: U23.2 (A1), U24.2 (A1), U25.2 (A1), U26.2 (A1)
OW3: U23.3 (A2), U24.3 (A2), U25.3 (A2), U26.3 (A2)
OW4: U5.11, U24.5 (E2), U25.6 (E3), U26.4 (E1)
OW5: U23.6 (E3), U24.6 (E3), U25.5 (E2), U26.5 (E2)
OW6: U29.1 (A0), U30.1 (A0), U31.1 (A0), U32.1 (A0)
OW7: U29.2 (A1), U30.2 (A1), U31.2 (A1), U32.2 (A1)
OW8: U29.3 (A2), U30.3 (A2), U31.3 (A2), U32.3 (A2)
OW9: U5.13, U30.5 (E2), U31.6 (E3), U32.4 (E1)
OW10: U29.6 (E3), U30.6 (E3), U31.5 (E2), U32.5 (E2)

Notes on the sheet:
Display High Word Code Converter
DSKY-DSP-DCD: Decode Data Copyright 2021, William Glasford
Display Low Word Code Converter
