bglasford1/AgcBlockIIComputer/schematics/DSKY/DSKY_DSP_DRV.sch

## KiCad design schematics/DSKY/DSKY_DSP_DRV.sch (2022-04-18)

Schematic: DSKY_DSP_DRV.sch

Parts:
U42, U43, U44, U45: ICM7218A
U76: 74LS08

Notes on the sheet:
DSKY-DSP-DRV: Driver Logic Copyright 2021, William Glasford Board #2
Decoder1
Decoder2
Decoder3
Decoder4
