bglasford1/AgcBlockIIComputer/schematics/DSKY/DSKY_DSP_IND.sch

## KiCad design schematics/DSKY/DSKY_DSP_IND.sch (2022-04-18)

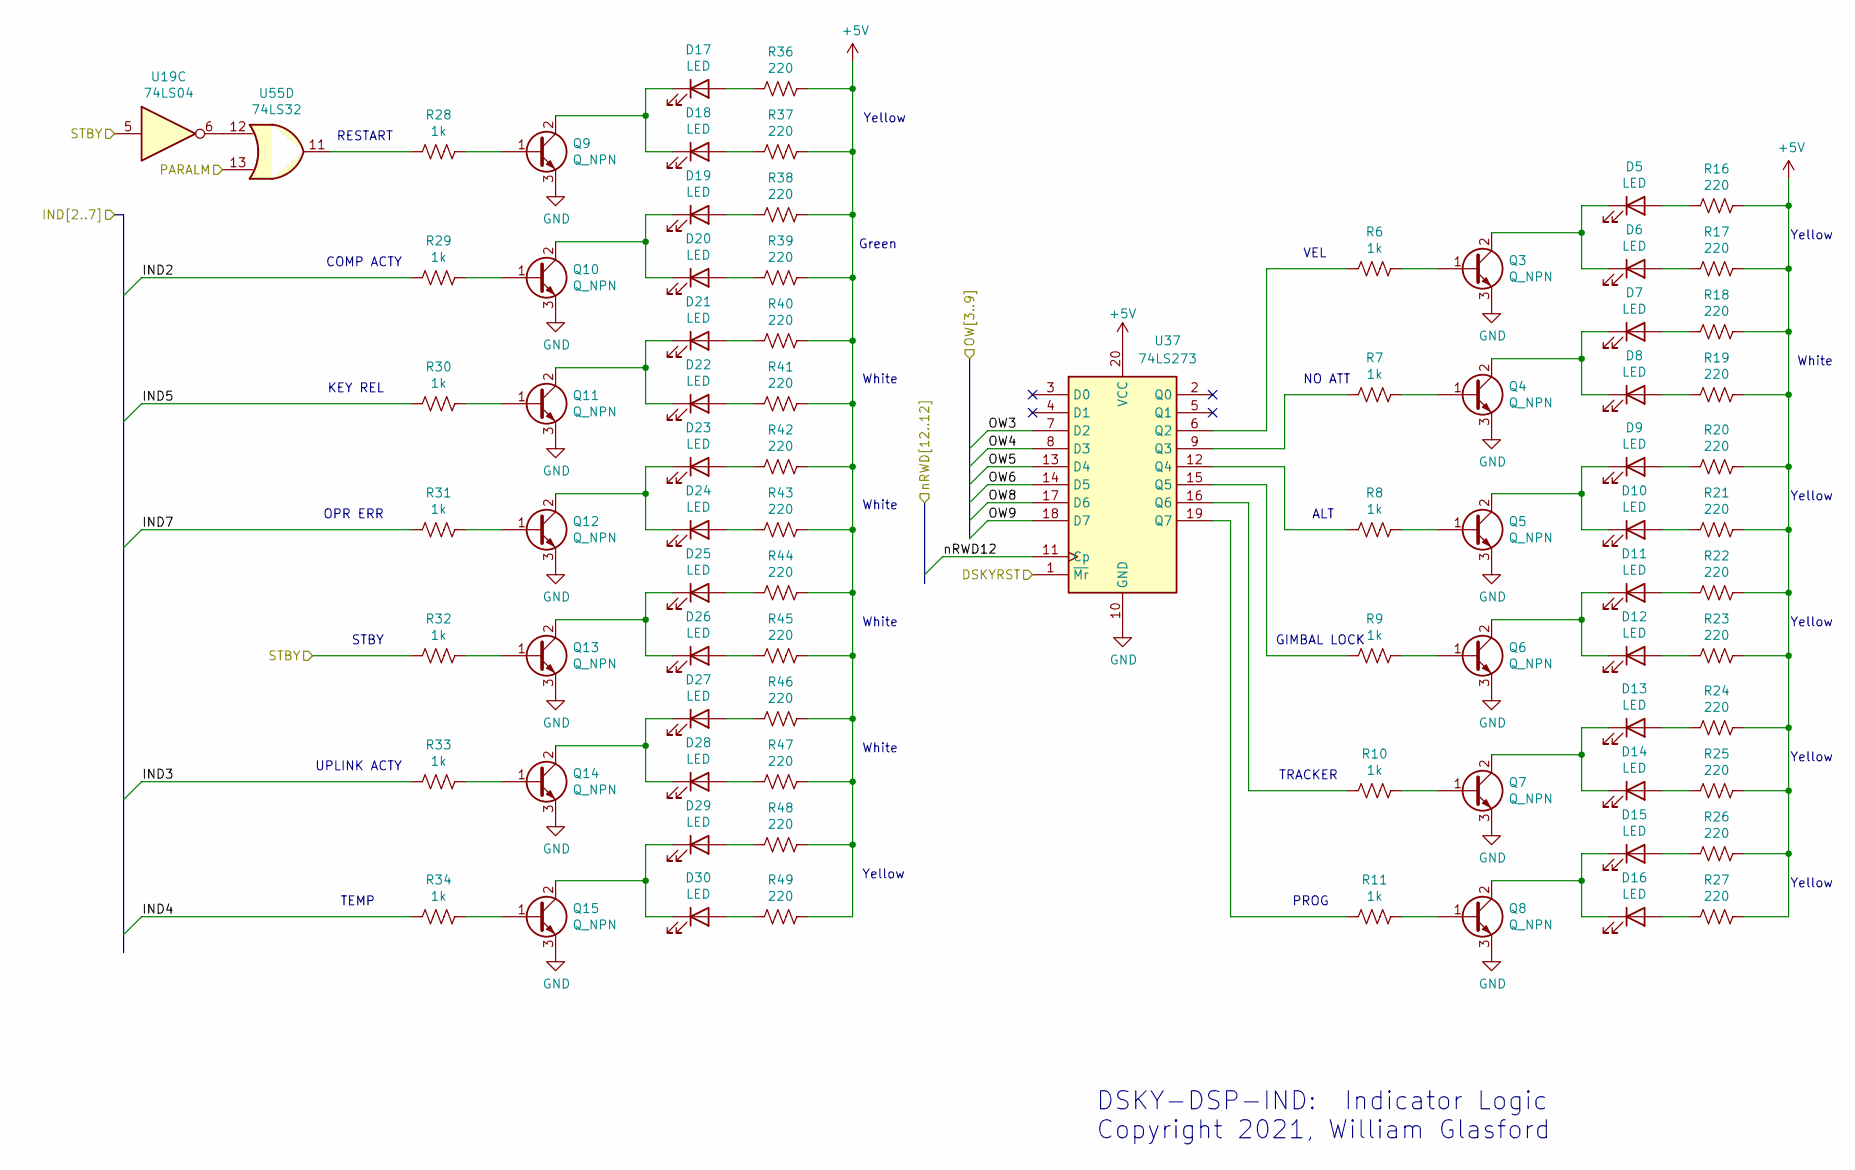
[picture p8: schematic DSKY_DSP_IND.sch]

Parts:
D5, D6, D7, D8, D9, D10, D11, D12, D13, D14, D15, D16, D17, D18, D19, D20, D21, D22, D23, D24, D25, D26, D27, D28, D29, D30: LED
Q3, Q4, Q5, Q6, Q7, Q8, Q9, Q10, Q11, Q12, Q13, Q14, Q15: Q_NPN
R6, R7, R8, R9, R10, R11, R28, R29, R30, R31, R32, R33, R34: 1k
R16, R17, R18, R19, R20, R21, R22, R23, R24, R25, R26, R27, R36, R37, R38, R39, R40, R41, R42, R43, R44, R45, R46, R47, R48, R49: 220
U19: 74LS04
U37: 74LS273
U55: 74LS32

Connections:
+5V: R16.2, R17.2, R18.2, R19.2, R20.2, R21.2, R22.2, R23.2, R24.2, R25.2, R26.2, R27.2, R36.2, R37.2, R38.2, R39.2, R40.2, R41.2, R42.2, R43.2, R44.2, R45.2, R46.2, R47.2, R48.2, R49.2, U37.20 (VCC)
DSKYRST: U37.1 (~Mr)
GND: Q3.3 (E), Q4.3 (E), Q5.3 (E), Q6.3 (E), Q7.3 (E), Q8.3 (E), Q9.3 (E), Q10.3 (E), Q11.3 (E), Q12.3 (E), Q13.3 (E), Q14.3 (E), Q15.3 (E), U37.10 (GND)
IND2: R29.1
IND3: R33.1
IND4: R34.1
IND5: R30.1
IND7: R31.1
unnamed: D5.1 (K), D6.1 (K), Q3.2 (C)
unnamed: D5.2 (A), R16.1
unnamed: D6.2 (A), R17.1
unnamed: D7.1 (K), D8.1 (K), Q4.2 (C)
unnamed: D7.2 (A), R18.1
unnamed: D8.2 (A), R19.1
unnamed: D9.2 (A), R20.1
unnamed: D9.1 (K), D10.1 (K), Q5.2 (C)
unnamed: D10.2 (A), R21.1
unnamed: D11.1 (K), D12.1 (K), Q6.2 (C)
unnamed: D11.2 (A), R22.1
unnamed: D12.2 (A), R23.1
unnamed: D13.1 (K), D14.1 (K), Q7.2 (C)
unnamed: D13.2 (A), R24.1
unnamed: D14.2 (A), R25.1
unnamed: D15.1 (K), D16.1 (K), Q8.2 (C)
unnamed: D15.2 (A), R26.1
unnamed: D16.2 (A), R27.1
unnamed: D17.1 (K), D18.1 (K), Q9.2 (C)
unnamed: D17.2 (A), R36.1
unnamed: D18.2 (A), R37.1
unnamed: D19.1 (K), D20.1 (K), Q10.2 (C)
unnamed: D19.2 (A), R38.1
unnamed: D20.2 (A), R39.1
unnamed: D21.1 (K), D22.1 (K), Q11.2 (C)
unnamed: D21.2 (A), R40.1
unnamed: D22.2 (A), R41.1
unnamed: D23.1 (K), D24.1 (K), Q12.2 (C)
unnamed: D23.2 (A), R42.1
unnamed: D24.2 (A), R43.1
unnamed: D25.1 (K), D26.1 (K), Q13.2 (C)
unnamed: D25.2 (A), R44.1
unnamed: D26.2 (A), R45.1
unnamed: D27.1 (K), D28.1 (K), Q14.2 (C)
unnamed: D27.2 (A), R46.1
unnamed: D28.2 (A), R47.1
unnamed: D29.1 (K), D30.1 (K), Q15.2 (C)
unnamed: D29.2 (A), R48.1
unnamed: D30.2 (A), R49.1
unnamed: Q3.1 (B), R6.2
unnamed: Q4.1 (B), R7.2
unnamed: Q5.1 (B), R8.2
unnamed: Q6.1 (B), R9.2
unnamed: Q7.1 (B), R10.2
unnamed: Q8.1 (B), R11.2
unnamed: Q9.1 (B), R28.2
unnamed: Q10.1 (B), R29.2
unnamed: Q11.1 (B), R30.2
unnamed: Q12.1 (B), R31.2
unnamed: Q13.1 (B), R32.2
unnamed: Q14.1 (B), R33.2
unnamed: Q15.1 (B), R34.2
unnamed: R6.1, U37.6 (Q2)
unnamed: R7.1, U37.9 (Q3)
unnamed: R8.1, U37.12 (Q4)
unnamed: R9.1, U37.15 (Q5)
unnamed: R10.1, U37.16 (Q6)
unnamed: R11.1, U37.19 (Q7)
unnamed: R28.1, U55.11
unnamed: U19.6, U55.12
OW3: U37.7 (D2)
OW4: U37.8 (D3)
OW5: U37.13 (D4)
OW6: U37.14 (D5)
OW8: U37.17 (D6)
OW9: U37.18 (D7)
PARALM: U55.13
STBY: R32.1, U19.5
nRWD12: U37.11 (Cp)

Notes on the sheet:
Yellow
PROG
TRACKER
GIMBAL LOCK
ALT
White
NO ATT
VEL
RESTART
COMP ACTY
KEY REL
OPR ERR
UPLINK ACTY
TEMP
Green
DSKY-DSP-IND: Indicator Logic Copyright 2021, William Glasford
STBY
