bglasford1/AgcBlockIIComputer/schematics/DSKY/DSKY_DSP_LCD.sch

## KiCad design schematics/DSKY/DSKY_DSP_LCD.sch (2022-04-18)

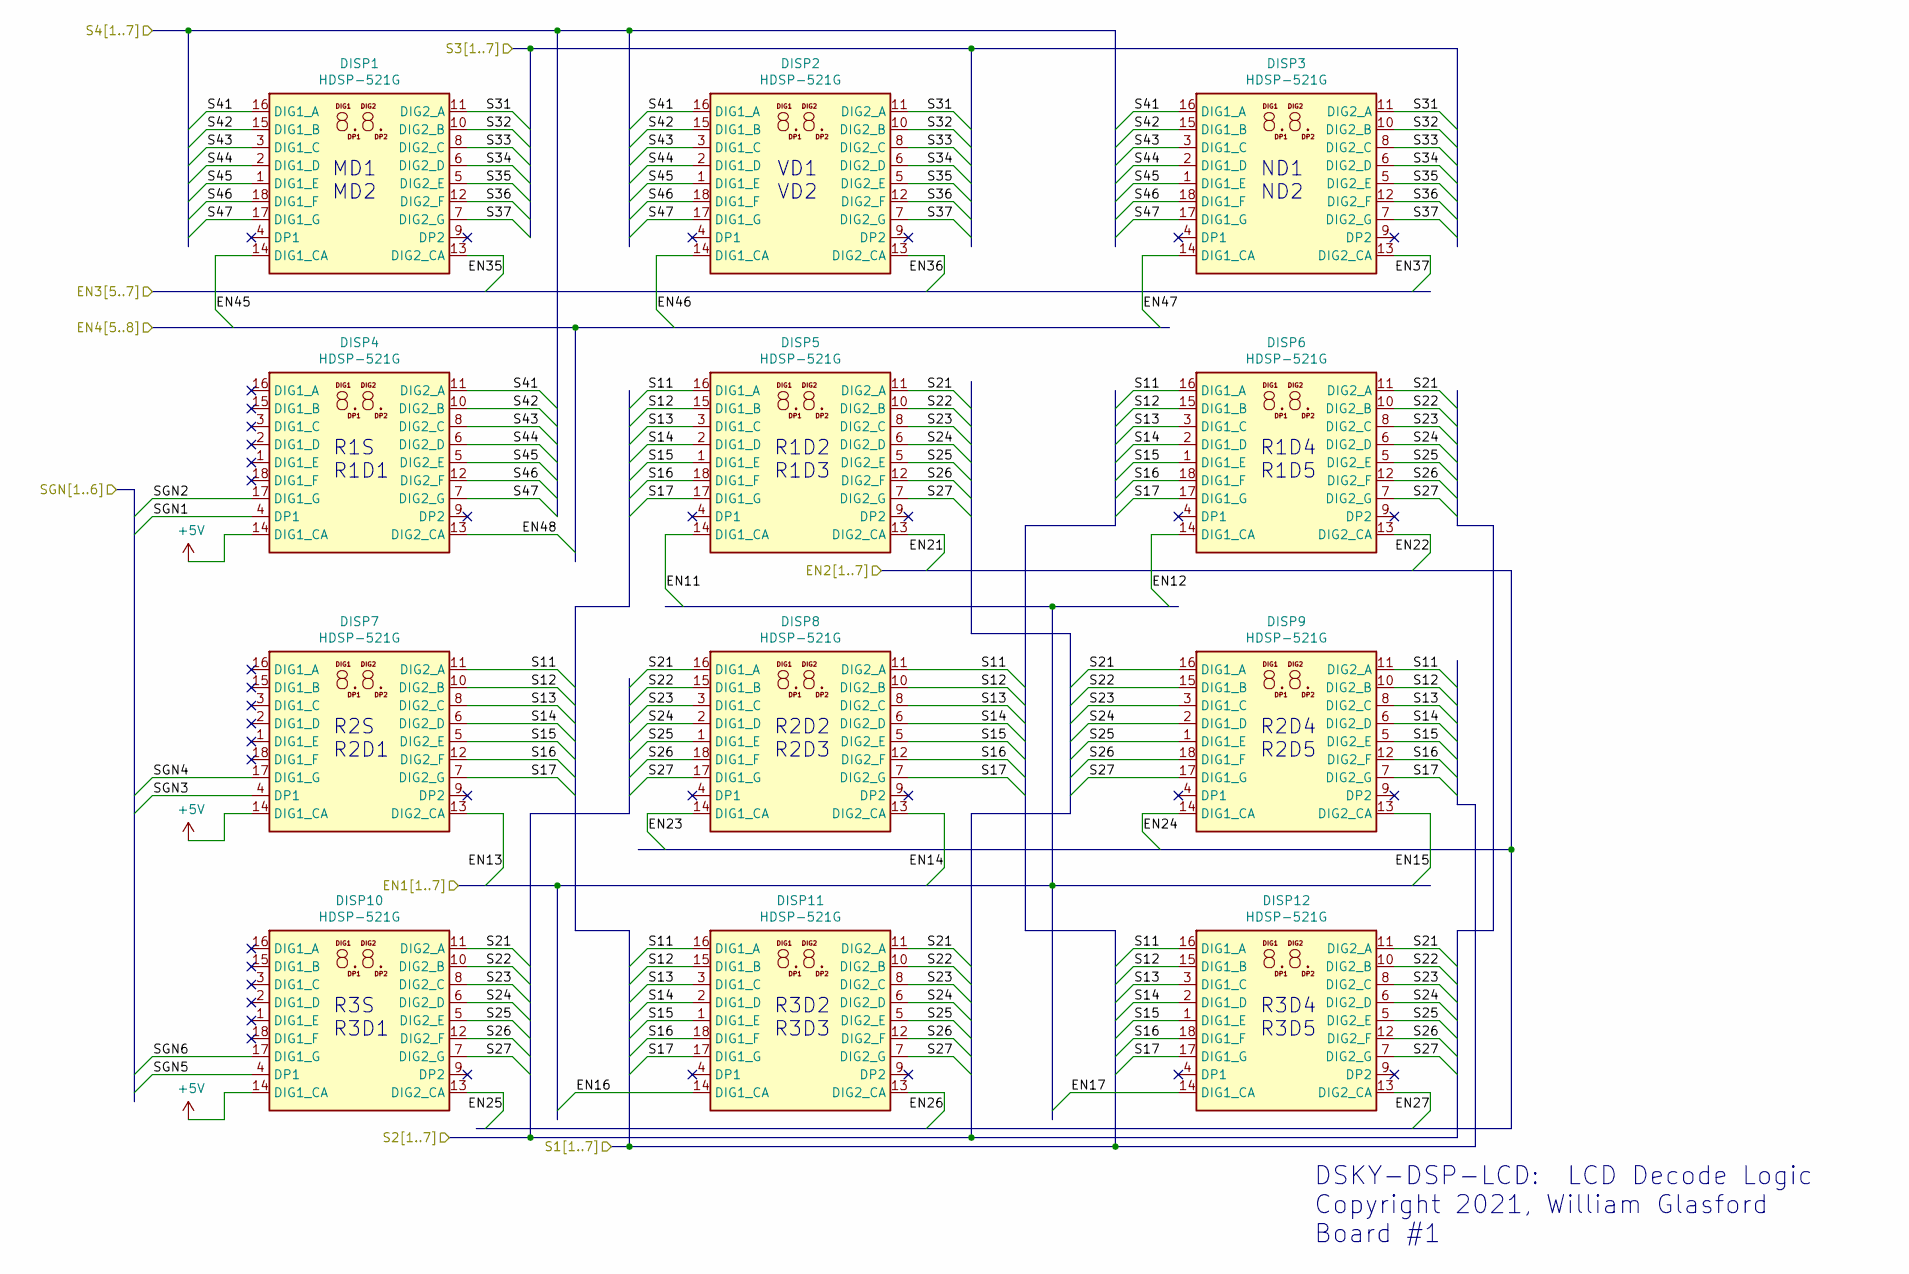
[picture p9: schematic DSKY_DSP_LCD.sch]

Parts:
DISP1, DISP2, DISP3, DISP4, DISP5, DISP6, DISP7, DISP8, DISP9, DISP10, DISP11, DISP12: HDSP-521G; DA56-11CGKWA

Connections:
+5V: DISP4.14 (DIG1_CA), DISP7.14 (DIG1_CA), DISP10.14 (DIG1_CA)
EN11: DISP5.14 (DIG1_CA)
EN12: DISP6.14 (DIG1_CA)
EN13: DISP7.13 (DIG2_CA)
EN14: DISP8.13 (DIG2_CA)
EN15: DISP9.13 (DIG2_CA)
EN16: DISP11.14 (DIG1_CA)
EN17: DISP12.14 (DIG1_CA)
EN21: DISP5.13 (DIG2_CA)
EN22: DISP6.13 (DIG2_CA)
EN23: DISP8.14 (DIG1_CA)
EN24: DISP9.14 (DIG1_CA)
EN25: DISP10.13 (DIG2_CA)
EN26: DISP11.13 (DIG2_CA)
EN27: DISP12.13 (DIG2_CA)
EN35: DISP1.13 (DIG2_CA)
EN36: DISP2.13 (DIG2_CA)
EN37: DISP3.13 (DIG2_CA)
EN45: DISP1.14 (DIG1_CA)
EN46: DISP2.14 (DIG1_CA)
EN47: DISP3.14 (DIG1_CA)
EN48: DISP4.13 (DIG2_CA)
S11: DISP5.16 (DIG1_A), DISP6.16 (DIG1_A), DISP7.11 (DIG2_A), DISP8.11 (DIG2_A), DISP9.11 (DIG2_A), DISP11.16 (DIG1_A), DISP12.16 (DIG1_A)
S12: DISP5.15 (DIG1_B), DISP6.15 (DIG1_B), DISP7.10 (DIG2_B), DISP8.10 (DIG2_B), DISP9.10 (DIG2_B), DISP11.15 (DIG1_B), DISP12.15 (DIG1_B)
S13: DISP5.3 (DIG1_C), DISP6.3 (DIG1_C), DISP7.8 (DIG2_C), DISP8.8 (DIG2_C), DISP9.8 (DIG2_C), DISP11.3 (DIG1_C), DISP12.3 (DIG1_C)
S14: DISP5.2 (DIG1_D), DISP6.2 (DIG1_D), DISP7.6 (DIG2_D), DISP8.6 (DIG2_D), DISP9.6 (DIG2_D), DISP11.2 (DIG1_D), DISP12.2 (DIG1_D)
S15: DISP5.1 (DIG1_E), DISP6.1 (DIG1_E), DISP7.5 (DIG2_E), DISP8.5 (DIG2_E), DISP9.5 (DIG2_E), DISP11.1 (DIG1_E), DISP12.1 (DIG1_E)
S16: DISP5.18 (DIG1_F), DISP6.18 (DIG1_F), DISP7.12 (DIG2_F), DISP8.12 (DIG2_F), DISP9.12 (DIG2_F), DISP11.18 (DIG1_F), DISP12.18 (DIG1_F)
S17: DISP5.17 (DIG1_G), DISP6.17 (DIG1_G), DISP7.7 (DIG2_G), DISP8.7 (DIG2_G), DISP9.7 (DIG2_G), DISP11.17 (DIG1_G), DISP12.17 (DIG1_G)
S21: DISP5.11 (DIG2_A), DISP6.11 (DIG2_A), DISP8.16 (DIG1_A), DISP9.16 (DIG1_A), DISP10.11 (DIG2_A), DISP11.11 (DIG2_A), DISP12.11 (DIG2_A)
S22: DISP5.10 (DIG2_B), DISP6.10 (DIG2_B), DISP8.15 (DIG1_B), DISP9.15 (DIG1_B), DISP10.10 (DIG2_B), DISP11.10 (DIG2_B), DISP12.10 (DIG2_B)
S23: DISP5.8 (DIG2_C), DISP6.8 (DIG2_C), DISP8.3 (DIG1_C), DISP9.3 (DIG1_C), DISP10.8 (DIG2_C), DISP11.8 (DIG2_C), DISP12.8 (DIG2_C)
S24: DISP5.6 (DIG2_D), DISP6.6 (DIG2_D), DISP8.2 (DIG1_D), DISP9.2 (DIG1_D), DISP10.6 (DIG2_D), DISP11.6 (DIG2_D), DISP12.6 (DIG2_D)
S25: DISP5.5 (DIG2_E), DISP6.5 (DIG2_E), DISP8.1 (DIG1_E), DISP9.1 (DIG1_E), DISP10.5 (DIG2_E), DISP11.5 (DIG2_E), DISP12.5 (DIG2_E)
S26: DISP5.12 (DIG2_F), DISP6.12 (DIG2_F), DISP8.18 (DIG1_F), DISP9.18 (DIG1_F), DISP10.12 (DIG2_F), DISP11.12 (DIG2_F), DISP12.12 (DIG2_F)
S27: DISP5.7 (DIG2_G), DISP6.7 (DIG2_G), DISP8.17 (DIG1_G), DISP9.17 (DIG1_G), DISP10.7 (DIG2_G), DISP11.7 (DIG2_G), DISP12.7 (DIG2_G)
S31: DISP1.11 (DIG2_A), DISP2.11 (DIG2_A), DISP3.11 (DIG2_A)
S32: DISP1.10 (DIG2_B), DISP2.10 (DIG2_B), DISP3.10 (DIG2_B)
S33: DISP1.8 (DIG2_C), DISP2.8 (DIG2_C), DISP3.8 (DIG2_C)
S34: DISP1.6 (DIG2_D), DISP2.6 (DIG2_D), DISP3.6 (DIG2_D)
S35: DISP1.5 (DIG2_E), DISP2.5 (DIG2_E), DISP3.5 (DIG2_E)
S36: DISP1.12 (DIG2_F), DISP2.12 (DIG2_F), DISP3.12 (DIG2_F)
S37: DISP1.7 (DIG2_G), DISP2.7 (DIG2_G), DISP3.7 (DIG2_G)
S41: DISP1.16 (DIG1_A), DISP2.16 (DIG1_A), DISP3.16 (DIG1_A), DISP4.11 (DIG2_A)
S42: DISP1.15 (DIG1_B), DISP2.15 (DIG1_B), DISP3.15 (DIG1_B), DISP4.10 (DIG2_B)
S43: DISP1.3 (DIG1_C), DISP2.3 (DIG1_C), DISP3.3 (DIG1_C), DISP4.8 (DIG2_C)
S44: DISP1.2 (DIG1_D), DISP2.2 (DIG1_D), DISP3.2 (DIG1_D), DISP4.6 (DIG2_D)
S45: DISP1.1 (DIG1_E), DISP2.1 (DIG1_E), DISP3.1 (DIG1_E), DISP4.5 (DIG2_E)
S46: DISP1.18 (DIG1_F), DISP2.18 (DIG1_F), DISP3.18 (DIG1_F), DISP4.12 (DIG2_F)
S47: DISP1.17 (DIG1_G), DISP2.17 (DIG1_G), DISP3.17 (DIG1_G), DISP4.7 (DIG2_G)
SGN1: DISP4.4 (DP1)
SGN2: DISP4.17 (DIG1_G)
SGN3: DISP7.4 (DP1)
SGN4: DISP7.17 (DIG1_G)
SGN5: DISP10.4 (DP1)
SGN6: DISP10.17 (DIG1_G)

Notes on the sheet:
VD1 VD2
MD1 MD2
ND1 ND2
DSKY-DSP-LCD: LCD Decode Logic Copyright 2021, William Glasford Board #1
R2D4 R2D5
R3D4 R3D5
R2D2 R2D3
R3D2 R3D3
R2S R2D1
R3S R3D1
R1S R1D1
R1D2 R1D3
R1D4 R1D5
