bglasford1/AgcBlockIIComputer/schematics/DSKY/DSKY_DSP_REG.sch

## KiCad design schematics/DSKY/DSKY_DSP_REG.sch (2022-04-18)

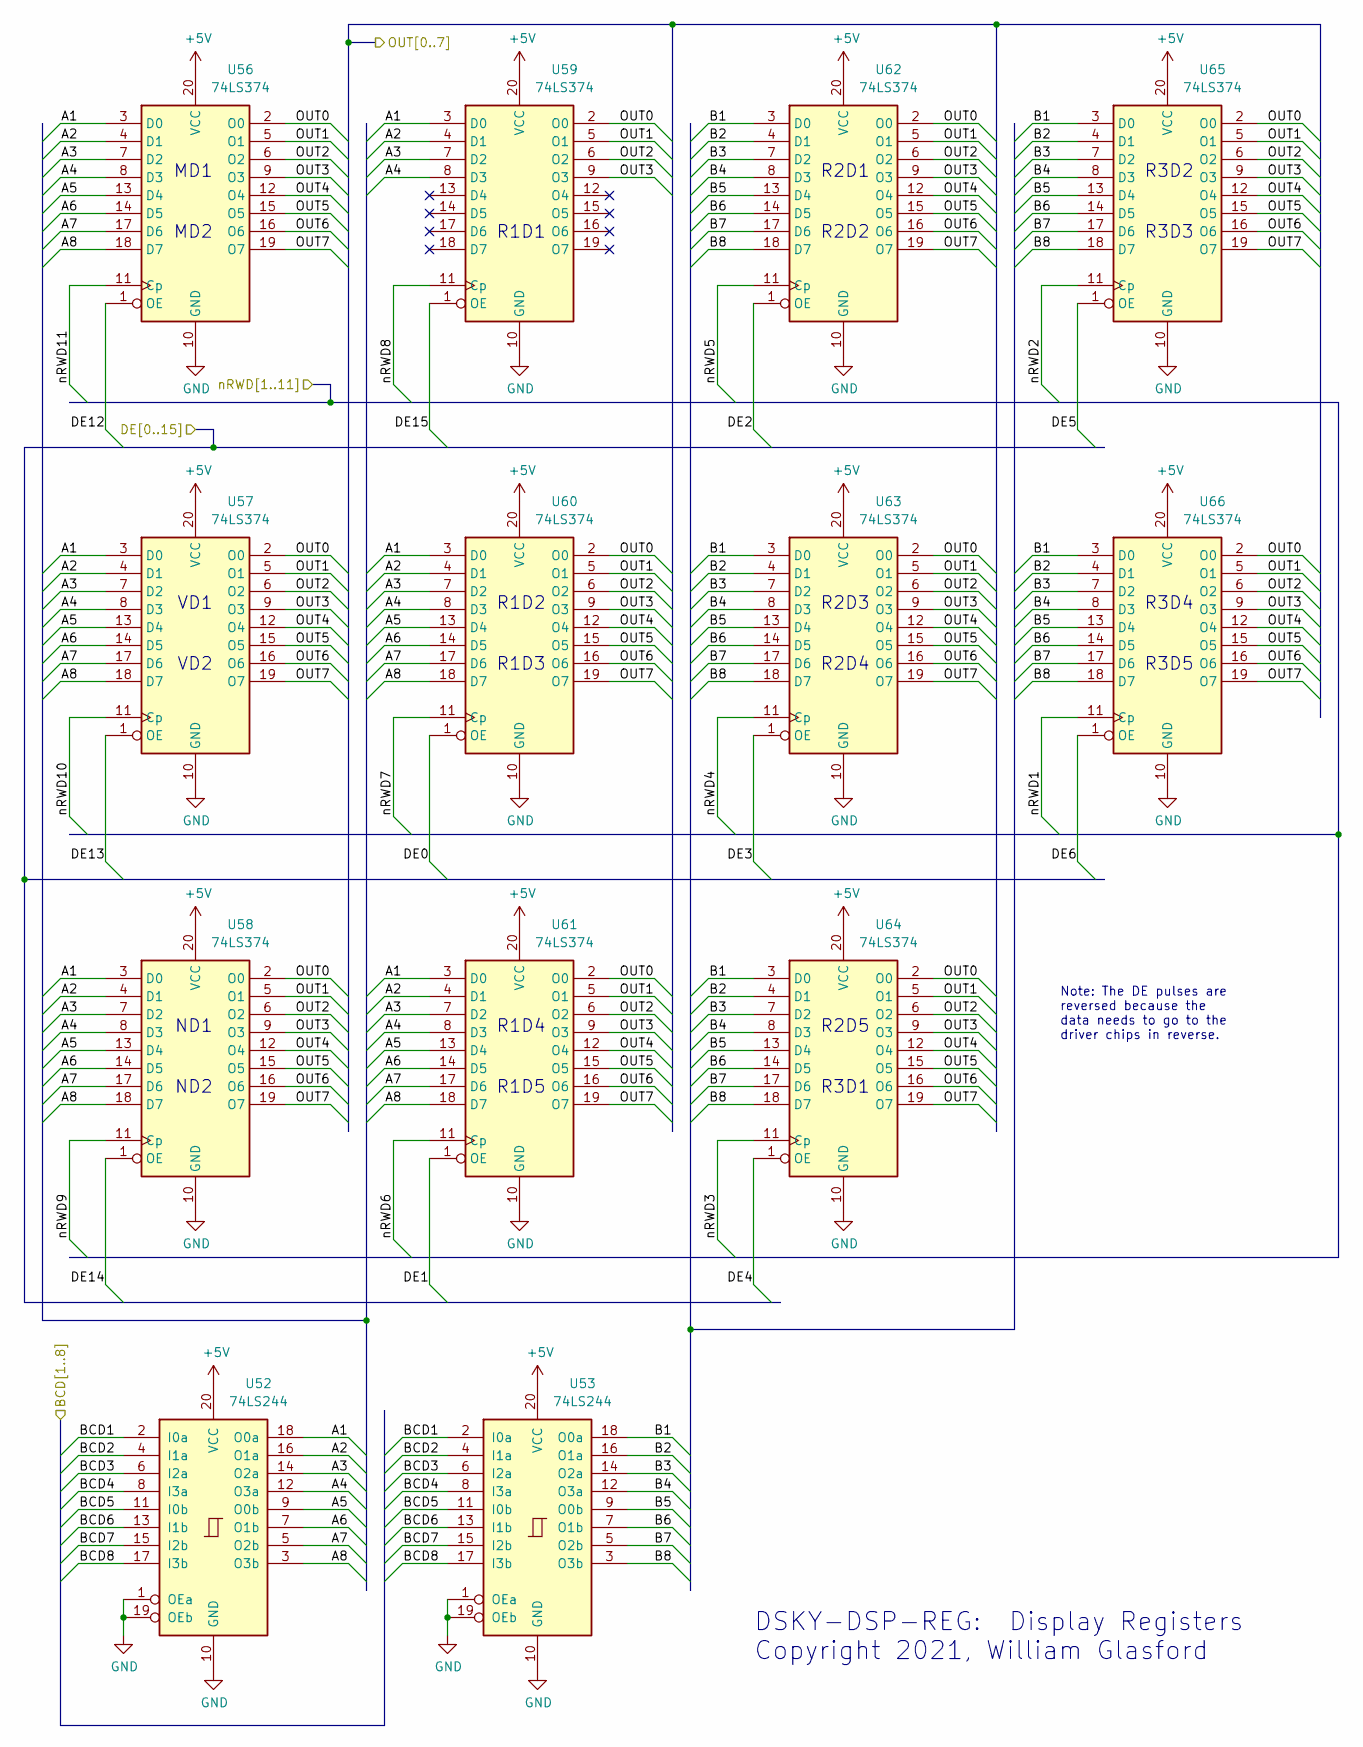
[picture p10: schematic DSKY_DSP_REG.sch]

Parts:
U52, U53: 74LS244
U56, U57, U58, U59, U60, U61, U62, U63, U64, U65, U66: 74LS374

Connections:
+5V: U52.20 (VCC), U53.20 (VCC), U56.20 (VCC), U57.20 (VCC), U58.20 (VCC), U59.20 (VCC), U60.20 (VCC), U61.20 (VCC), U62.20 (VCC), U63.20 (VCC), U64.20 (VCC), U65.20 (VCC), U66.20 (VCC)
A1: U52.18 (O0a), U56.3 (D0), U57.3 (D0), U58.3 (D0), U59.3 (D0), U60.3 (D0), U61.3 (D0)
A2: U52.16 (O1a), U56.4 (D1), U57.4 (D1), U58.4 (D1), U59.4 (D1), U60.4 (D1), U61.4 (D1)
A3: U52.14 (O2a), U56.7 (D2), U57.7 (D2), U58.7 (D2), U59.7 (D2), U60.7 (D2), U61.7 (D2)
A4: U52.12 (O3a), U56.8 (D3), U57.8 (D3), U58.8 (D3), U59.8 (D3), U60.8 (D3), U61.8 (D3)
A5: U52.9 (O0b), U56.13 (D4), U57.13 (D4), U58.13 (D4), U60.13 (D4), U61.13 (D4)
A6: U52.7 (O1b), U56.14 (D5), U57.14 (D5), U58.14 (D5), U60.14 (D5), U61.14 (D5)
A7: U52.5 (O2b), U56.17 (D6), U57.17 (D6), U58.17 (D6), U60.17 (D6), U61.17 (D6)
A8: U52.3 (O3b), U56.18 (D7), U57.18 (D7), U58.18 (D7), U60.18 (D7), U61.18 (D7)
B1: U53.18 (O0a), U62.3 (D0), U63.3 (D0), U64.3 (D0), U65.3 (D0), U66.3 (D0)
B2: U53.16 (O1a), U62.4 (D1), U63.4 (D1), U64.4 (D1), U65.4 (D1), U66.4 (D1)
B3: U53.14 (O2a), U62.7 (D2), U63.7 (D2), U64.7 (D2), U65.7 (D2), U66.7 (D2)
B4: U53.12 (O3a), U62.8 (D3), U63.8 (D3), U64.8 (D3), U65.8 (D3), U66.8 (D3)
B5: U53.9 (O0b), U62.13 (D4), U63.13 (D4), U64.13 (D4), U65.13 (D4), U66.13 (D4)
B6: U53.7 (O1b), U62.14 (D5), U63.14 (D5), U64.14 (D5), U65.14 (D5), U66.14 (D5)
B7: U53.5 (O2b), U62.17 (D6), U63.17 (D6), U64.17 (D6), U65.17 (D6), U66.17 (D6)
B8: U53.3 (O3b), U62.18 (D7), U63.18 (D7), U64.18 (D7), U65.18 (D7), U66.18 (D7)
BCD1: U52.2 (I0a), U53.2 (I0a)
BCD2: U52.4 (I1a), U53.4 (I1a)
BCD3: U52.6 (I2a), U53.6 (I2a)
BCD4: U52.8 (I3a), U53.8 (I3a)
BCD5: U52.11 (I0b), U53.11 (I0b)
BCD6: U52.13 (I1b), U53.13 (I1b)
BCD7: U52.15 (I2b), U53.15 (I2b)
BCD8: U52.17 (I3b), U53.17 (I3b)
DE0: U60.1 (OE)
DE1: U61.1 (OE)
DE2: U62.1 (OE)
DE3: U63.1 (OE)
DE4: U64.1 (OE)
DE5: U65.1 (OE)
DE6: U66.1 (OE)
DE12: U56.1 (OE)
DE13: U57.1 (OE)
DE14: U58.1 (OE)
DE15: U59.1 (OE)
GND: U52.1 (OEa), U52.10 (GND), U52.19 (OEb), U53.1 (OEa), U53.10 (GND), U53.19 (OEb), U56.10 (GND), U57.10 (GND), U58.10 (GND), U59.10 (GND), U60.10 (GND), U61.10 (GND), U62.10 (GND), U63.10 (GND), U64.10 (GND), U65.10 (GND), U66.10 (GND)
OUT0: U56.2 (O0), U57.2 (O0), U58.2 (O0), U59.2 (O0), U60.2 (O0), U61.2 (O0), U62.2 (O0), U63.2 (O0), U64.2 (O0), U65.2 (O0), U66.2 (O0)
OUT1: U56.5 (O1), U57.5 (O1), U58.5 (O1), U59.5 (O1), U60.5 (O1), U61.5 (O1), U62.5 (O1), U63.5 (O1), U64.5 (O1), U65.5 (O1), U66.5 (O1)
OUT2: U56.6 (O2), U57.6 (O2), U58.6 (O2), U59.6 (O2), U60.6 (O2), U61.6 (O2), U62.6 (O2), U63.6 (O2), U64.6 (O2), U65.6 (O2), U66.6 (O2)
OUT3: U56.9 (O3), U57.9 (O3), U58.9 (O3), U59.9 (O3), U60.9 (O3), U61.9 (O3), U62.9 (O3), U63.9 (O3), U64.9 (O3), U65.9 (O3), U66.9 (O3)
OUT4: U56.12 (O4), U57.12 (O4), U58.12 (O4), U60.12 (O4), U61.12 (O4), U62.12 (O4), U63.12 (O4), U64.12 (O4), U65.12 (O4), U66.12 (O4)
OUT5: U56.15 (O5), U57.15 (O5), U58.15 (O5), U60.15 (O5), U61.15 (O5), U62.15 (O5), U63.15 (O5), U64.15 (O5), U65.15 (O5), U66.15 (O5)
OUT6: U56.16 (O6), U57.16 (O6), U58.16 (O6), U60.16 (O6), U61.16 (O6), U62.16 (O6), U63.16 (O6), U64.16 (O6), U65.16 (O6), U66.16 (O6)
OUT7: U56.19 (O7), U57.19 (O7), U58.19 (O7), U60.19 (O7), U61.19 (O7), U62.19 (O7), U63.19 (O7), U64.19 (O7), U65.19 (O7), U66.19 (O7)
nRWD1: U66.11 (Cp)
nRWD2: U65.11 (Cp)
nRWD3: U64.11 (Cp)
nRWD4: U63.11 (Cp)
nRWD5: U62.11 (Cp)
nRWD6: U61.11 (Cp)
nRWD7: U60.11 (Cp)
nRWD8: U59.11 (Cp)
nRWD9: U58.11 (Cp)
nRWD10: U57.11 (Cp)
nRWD11: U56.11 (Cp)

Notes on the sheet:
DSKY-DSP-REG: Display Registers Copyright 2021, William Glasford
MD1 MD2
VD1 VD2
ND1 ND2
R1D1
R1D2 R1D3
R1D4 R1D5
R2D1 R2D2
R2D3 R2D4
R2D5 R3D1
R3D2 R3D3
R3D4 R3D5
Note: The DE pulses are reversed because the data needs to go to the driver chips in reverse.
