bglasford1/AgcBlockIIComputer/schematics/MEM/ MEM_ADR_MDE.sch

## KiCad design schematics/MEM/ MEM_ADR_MDE.sch (2021-09-05)

Schematic:  MEM_ADR_MDE.sch

Parts:
U12, U13, U14, U15: 74LS193
U16, U17, U18, U19: 74LS244
U87: 74LS04
U88: 74LS02

Notes on the sheet:
EXAMINE (Load Address)
Memory Switch Bus
Address Bus
0 = normal oper. 1 = manual oper.
Manual Address Bus
MEM-ADR-MDE: Manual Data Entry Copyright 2021, William Glasford
Examine Next
Memory Authority
Clock Mode
