bglasford1/AgcBlockIIComputer/schematics/MEM/MEM_ADR_ATS.sch

## KiCad design schematics/MEM/MEM_ADR_ATS.sch (2021-09-05)

Schematic: MEM_ADR_ATS.sch

Parts:
U20, U21, U22, U23, U24, U25, U26, U27: 74LS244
U86: 74LS32
U87: 74LS04
U88: 74LS02
U89: 74LS20
U91: 74LS11
U92, U94, U95, U97: 74LS08
U126: 74LS00

Notes on the sheet:
Addr < 01400 if bits 11,12 = 0
01400 <= Addr < 02000 if bits 9,10=1 & 11,12 = 0
02000 <= Addr < 04000 if bits 11=1, 12 = 0
04000 <= Addr < 06000 if bits 11=0, 12 = 1
Addr >= 06000 if bits 11,12 = 1
Z Reg. Inputs
MEM-ADR-ATS: Address Decoding Logic Copyright 2021, William Glasford
