bglasford1/AgcBlockIIComputer/schematics/MEM/MEM_ADR_BNK.sch

## KiCad design schematics/MEM/MEM_ADR_BNK.sch (2021-09-05)

Schematic: MEM_ADR_BNK.sch

Parts:
U6, U7, U10, U11: 74LS244
U8, U9: 74LS273
U74: 74LS74
U81: 74LS04
U82: 74LS00
U84, U133: 74LS10
U86: 74LS32

Notes on the sheet:
BANK Register
E-BANK Mon Bus
F-BANK Mon Bus
Write Channel 7 bit 7, the Super-bank bit
MEM-ADR-BNK: E/F Bank Registers Copyright 2021, William Glasford
