bglasford1/AgcBlockIIComputer/schematics/MEM/MEM_ADR_CTL.sch

## KiCad design schematics/MEM/MEM_ADR_CTL.sch (2022-04-18)

Schematic: MEM_ADR_CTL.sch

Parts:
U81, U87, U99, U135: 74LS04
U82, U126: 74LS00
U96: 74LS30
U97: 74LS08
U100: 74LS27
U101: 74LS20
U127, U128, U129, U130: 74LS86
U131, U132: 74LS02
U136: 74LS32

Notes on the sheet:
MEM-ADR-CTL: Control Logic Copyright 2021, William Glasford
