bglasford1/AgcBlockIIComputer/schematics/MEM/MEM_ADR_S.sch

## KiCad design schematics/MEM/MEM_ADR_S.sch (2021-09-05)

Schematic: MEM_ADR_S.sch

Parts:
U1, U2, U3, U4: 74LS273
U81: 74LS04
U82: 74LS00

Notes on the sheet:
Temp S Reg.
S Reg.
MEM-ADR-S: Temp S & S Registers Copyright 2021, William Glasford
