bglasford1/AgcBlockIIComputer/schematics/MEM/MEM_CTR_CNT.sch

## KiCad design schematics/MEM/MEM_CTR_CNT.sch (2021-09-05)

Schematic: MEM_CTR_CNT.sch

Parts:
U60: 74LS273
U61: 74LS151
U62: 74LS148
U63: 74LS138
U64, U65: 74LS244
U121: 74LS04
U122: 74LS00
U134: 74LS08

Notes on the sheet:
Plus Ctr
PINC Mux
PINC Demux
Priority Encoder
Plus In Sync
Selected Counter
Counter Address
Write Bus: 24 = cntr 1 (TIME2) 25 = cntr 2 (TIME1) 26 = cntr 3 (TIME3) 27 = cntr 4 (TIME4)
MEM-CTR-CNT: Counter Logic Copyright 2021, William Glasford
