bglasford1/AgcBlockIIComputer/schematics/MEM/MEM_CTR_CTL.sch

## KiCad design schematics/MEM/MEM_CTR_CTL.sch (2021-09-05)

Schematic: MEM_CTR_CTL.sch

Parts:
U66: 74LS126
U67: 74LS138
U77, U78: 74LS112
U122: 74LS00
U123: 74LS08
U124: 74LS04

Notes on the sheet:
TIME2
TIME1
TIME3
TIME4
Counter P Overflow
TM1RUPT
MEM-CTR-CTL: Counter Interrupt Logic Copyright 2021, William Glasford
