bglasford1/AgcBlockIIComputer/schematics/MEM/MEM_EFM.sch

## KiCad design schematics/MEM/MEM_EFM.sch (2021-09-05)

Schematic: MEM_EFM.sch

Parts:
U28: 27C1024; DIP-28_W15.24mm
U29, U30: 6264; DIP-28_W15.24mm
U31, U32: 74LS244
U97: 74LS08
U102, U104: 74LS00
U103: 74LS04
U105: 74LS10

Notes on the sheet:
Write Enable
Output Enable
Chip Enable
RAM
Memory Bus
Load Memory (manual)
MEM-EFM: Erasable/Fixed Memory Copyright 2021, William Glasford
Manual Read/Write
