bglasford1/AgcBlockIIComputer/schematics/MEM/MEM_INT.sch

## KiCad design schematics/MEM/MEM_INT.sch (2022-04-18)

Schematic: MEM_INT.sch

Parts:
R26, R27, R28: 1k
U55: 74LS148
U56: 74LS273
U57: 74LS138
U58, U59: 74LS244
U75, U76: 74LS112
U90: 74LS27
U110: 74LS10
U114: 74LS08
U120: 74LS00
U124: 74LS04

Notes on the sheet:
Selected RUPT
RUPT Latch
RUPT Address
RPCell
Priority Encoder
Set RUPT3 TIME3
Set RUPT4 TIME4
Set RUPT5 KEYRUPT1
Inhibit Interrupt IT_INH = 0 (S/W controlled)
Read Bus RUPT address (octal): 4014 = RUPT3(TIME3) 4020 = RUPT4 (TIME4) 4024 = RUPT5 (KBD)
= 04000 + RUPT << 2
MEM-INT: Interrupt Logic Copyright 2021, William Glasford
