bglasford1/AgcBlockIIComputer/schematics/MEM/MEM_MBF_GMB.sch

## KiCad design schematics/MEM/MEM_MBF_GMB.sch (2022-04-18)

Schematic: MEM_MBF_GMB.sch

Parts:
U49, U50, U51, U52, U53, U54: 74LS244
U88: 74LS02
U94: 74LS08
U106, U108, U111, U112, U124: 74LS04
U113: 74LS00
U115: 74LS27
U116, U117, U118: 74LS20
U136: 74LS32

Notes on the sheet:
G Mon Bus
MEM-MBF-GMB: G Register Output & Control Logic Copyright 2021, William Glasford
