bglasford1/AgcBlockIIComputer/schematics/MEM/MEM_MBF_MBL.sch

## KiCad design schematics/MEM/MEM_MBF_MBL.sch (2021-09-05)

Schematic: MEM_MBF_MBL.sch

Parts:
U43, U44, U45, U46: 74LS244
U47, U48: 74LS273
U106: 74LS04
U110: 74LS10
U113: 74LS00
U115: 74LS27

Notes on the sheet:
G Reg.
G Mux Bus
L2GD: Shift Left One Bit
Write to G reg. from Memory
MEM-MBF-MBL: G Register & Shift Logic Copyright 2021, William Glasford
