bglasford1/AgcBlockIIComputer/schematics/MEM/MEM_MBF_SFT.sch

## KiCad design schematics/MEM/MEM_MBF_SFT.sch (2021-09-05)

Schematic: MEM_MBF_SFT.sch

Parts:
U33, U34, U35, U36, U37, U38, U39, U40, U41, U42: 74LS244
U106: 74LS04
U107: 74LS00
U134: 74LS08
U136: 74LS32

Notes on the sheet:
Internal Write Bus
No Shift
Input From Write Bus
Shift Right (CYR, SR)
Shift Left (CYL)
G Mux Bus
MEM-MBF-SFT: Shift/Rotate Logic Copyright 2021, William Glasford
Shift Left 7-bits (EDOP)
