bglasford1/AgcBlockIIComputer/schematics/MEM/MEM_MMI.sch

## KiCad design schematics/MEM/MEM_MMI.sch (2022-04-18)

Schematic: MEM_MMI.sch

Parts:
J100, J106: Conn_02x20
J101, J107: Conn_02x08
J104, J105: Conn_02x10
J200, J201, J202, J204: Backplane
J203: Conn_01x10_Male
U80, U87: 74LS04

Notes on the sheet:
To PROC
Write Bus
From CTL
Channel Bus
CLK2
MEM-MMI: Interface Copyright 2021, William Glasford
