bglasford1/AgcBlockIIComputer/schematics/MEM/MEM_PAR.sch

## KiCad design schematics/MEM/MEM_PAR.sch (2021-09-05)

Schematic: MEM_PAR.sch

Parts:
U66: 74LS126
U68, U69: 74LS244
U70, U71: 74LS280
U79: 74LS74
U102: 74LS00
U103: 74LS04
U125: 74LS86
U133: 74LS10
U134: 74LS08

Notes on the sheet:
PR-16
PALM Reg.
P Mon Bus
Memory Bus
MEM-PAR: Parity Logic Copyright 2021, William Glasford
Clear Parity Alarm
