bglasford1/AgcBlockIIComputer/schematics/PROC/PROC_ALU_ADD.sch

## KiCad design schematics/PROC/PROC_ALU_ADD.sch (2022-07-07)

Schematic: PROC_ALU_ADD.sch

Parts:
U51, U52, U54, U55: 74LS83
U53, U56: 74LS244
U81: 74LS74
U82: 74LS112
U83: 74LS10
U111, U121: 74LS04
U120: 74LS32
U123: 74LS20
U124: 74LS00
U125: 74LS02

Notes on the sheet:
U Register
CI Reg
X Mon Bus
Y Mon Bus
U Mon Bus
Data clocks into X & Y on rising edge of CLK2. Carry-in is clocked into the end around carry on the falling edge of CLK2.
Carry Bit
TODO: These should be combined…
PROC-ALU-ADD: Adder Copyright 2021, William Glasford
