bglasford1/AgcBlockIIComputer/schematics/PROC/PROC_ALU_ALU.sch

## KiCad design schematics/PROC/PROC_ALU_ALU.sch (2022-07-07)

Schematic: PROC_ALU_ALU.sch

Parts:
U61, U62, U67, U68: 74LS244
U63, U64, U65, U66: 74LS181
U85: 74LS00
U102: 74LS08
U105: 74LS11
U115, U120: 74LS32
U121: 74LS04

Notes on the sheet:
U Mon Bus
B Mon Bus
Note: Pulses are negative logic. AS1 = RC * !RU + RB * !RC * RU AS2 = RB * !RU + !RB * RC * RU AS3 = RB * !RC * RU + RB * RC * !RU AS4 = !RB * RC * RU + RB * RC * !RU
PROC-ALU-ALU: ALU Logic Copyright 2021, William Glasford
