bglasford1/AgcBlockIIComputer/schematics/PROC/PROC_ALU_B.sch

## KiCad design schematics/PROC/PROC_ALU_B.sch (2022-07-07)

Schematic: PROC_ALU_B.sch

Parts:
U57, U58: 74LS273
U59, U60: 74LS244
U124: 74LS00

Notes on the sheet:
B Register
B Mon Bus
Internal Write Bus
PROC-ALU-B: B Register Copyright 2021, William Glasford
