bglasford1/AgcBlockIIComputer/schematics/PROC/PROC_ALU_VAL.sch

## KiCad design schematics/PROC/PROC_ALU_VAL.sch (2022-07-07)

Schematic: PROC_ALU_VAL.sch

Parts:
U69, U70, U71, U72: 74LS244
U83: 74LS10
U90, U91, U95, U96: 74LS32
U93: 74LS00
U114: 74LS04

Notes on the sheet:
PROC-ALU-VAL: Set Bus Bit Values Copyright 2021, William Glasford
