bglasford1/AgcBlockIIComputer/schematics/PROC/PROC_ALU_X.sch

## KiCad design schematics/PROC/PROC_ALU_X.sch (2022-07-07)

Schematic: PROC_ALU_X.sch

Parts:
U39, U40, U41, U42: 74LS244
U43, U44: 74LS273
U74, U92, U109, U112: 74LS00
U75: 74LS30
U84: 74LS27
U107: 74LS04
U113: 74LS20
U116, U117, U118, U119: 74LS32

Notes on the sheet:
X Register
X Mon Bus
X Mux Bus
PROC-ALU-X: X Register Copyright 2021, William Glasford
