bglasford1/AgcBlockIIComputer/schematics/PROC/PROC_ALU_Y.sch

## KiCad design schematics/PROC/PROC_ALU_Y.sch (2022-07-07)

Schematic: PROC_ALU_Y.sch

Parts:
U45, U46, U47, U48: 74LS244
U49, U50: 74LS273
U81: 74LS74
U84: 74LS27
U92, U112, U124: 74LS00
U94, U122: 74LS11
U106: 74LS126
U110: 74LS10
U111: 74LS04

Notes on the sheet:
Y Register
Y Mux Bus
WYD: Shift 1 bit left
Y Mon Bus
NEAC Register
PROC-ALU-Y: Y Register Copyright 2021, William Glasford
