bglasford1/AgcBlockIIComputer/schematics/PROC/PROC_CRG_AREG.sch

## KiCad design schematics/PROC/PROC_CRG_AREG.sch (2022-07-07)

Schematic: PROC_CRG_AREG.sch

Parts:
U25, U26, U27, U28, U31, U32, U33, U34: 74LS244
U29, U30: 74LS273
U76, U103: 74LS00
U78: 74LS08
U80, U121: 74LS04
U120: 74LS32
U123: 74LS20

Notes on the sheet:
A Register
WA Select
WALS Select
A MUX Bus
A Mon Bus
Disables output to bus while bus selection logic is settling during CLK1.
PROC-CRG-AREG: A Register Copyright 2021, William Glasford
