bglasford1/AgcBlockIIComputer/schematics/PROC/PROC_CRG_LPREG.sch

## KiCad design schematics/PROC/PROC_CRG_LPREG.sch (2022-07-07)

Schematic: PROC_CRG_LPREG.sch

Parts:
U5, U6: 74LS273
U77, U108, U109: 74LS00
U78: 74LS08
U106: 74LS126
U107: 74LS04
U110: 74LS10
U126, U127, U128, U129, U130, U131, U132, U133, U134, U135, U136, U137, U138, U139: 74LS244

Notes on the sheet:
L Register
L Mon Bus
Disables output to read bus while read bus selection logic is settling during CLK1.
L Mux Bus
Write Bus Input
PROC-CRG-LREG: L Register Copyright 2021, William Glasford
