bglasford1/AgcBlockIIComputer/schematics/PROC/PROC_CRG_QREG.sch

## KiCad design schematics/PROC/PROC_CRG_QREG.sch (2022-07-07)

Schematic: PROC_CRG_QREG.sch

Parts:
U15, U16, U17, U18, U21, U22, U23, U24: 74LS244
U19, U20: 74LS273
U74, U101: 74LS00

Notes on the sheet:
Q Mux Bus
Write Bus Input
Channel Input
Disables output to write bus while write bus selection logic is settling during CLK1.
Q Mon Bus
Q Register
PROC-CRG-QREG: Q Register Copyright 2021, William Glasford
