bglasford1/AgcBlockIIComputer/schematics/PROC/PROC_CRG_RCHN.sch

## KiCad design schematics/PROC/PROC_CRG_RCHN.sch (2022-07-07)

Schematic: PROC_CRG_RCHN.sch

Parts:
U7, U8, U9, U10: 74LS181
U11, U12: 74LS244
U73: 74LS30
U77, U93: 74LS00
U110: 74LS10
U114: 74LS04

Notes on the sheet:
PROC-CRG-RCHN: Read channel logic Copyright 2021, William Glasford
