bglasford1/AgcBlockIIComputer/schematics/PROC/PROC_CRG_WCHN.sch

## KiCad design schematics/PROC/PROC_CRG_WCHN.sch (2022-07-07)

Schematic: PROC_CRG_WCHN.sch

Parts:
U1, U2, U3, U4: 74LS181
U13, U14: 74LS244
U77: 74LS00
U114: 74LS04

Notes on the sheet:
PROC-CRG-WCHN: Write channel logic Copyright 2021, William Glasford
