bglasford1/AgcBlockIIComputer/schematics/PROC/PROC_CRG_ZREG.sch

## KiCad design schematics/PROC/PROC_CRG_ZREG.sch (2022-07-07)

Schematic: PROC_CRG_ZREG.sch

Parts:
U35, U36: 74LS273
U37, U38, U97, U98, U99, U100: 74LS244
U74, U76, U103: 74LS00
U104: 74LS10
U114: 74LS04

Notes on the sheet:
Disables output to read bus while read bus selection logic is settling during CLK1.
Z Mon Bus
Z Register
PROC-CRG-ZREG: Z Register Copyright 2021, William Glasford
Z Mux Bus
