bglasford1/AgcBlockIIComputer/schematics/PROC/PROC_PMI.sch

## KiCad design schematics/PROC/PROC_PMI.sch (2022-07-07)

Schematic: PROC_PMI.sch

Parts:
J100: Conn_02x20
J101: Conn_02x08
J102, J104, J105: Conn_02x10
J200, J201, J202, J203: Conn_01x40_Male
U79, U80: 74LS04
U86, U87, U88, U89: 74LS244
U103: 74LS00

Notes on the sheet:
To CTL
Channel Bus
To MEM
Write Bus
GENRST
PROC-PMI: Interface Copyright 2021, William Glasford
