bglasford1/AgcBlockIIComputer/Tester/DSKYTest.ino

/* Constructor:
      D0 - D3   : digital output data pins. D0 is LSB
      D4 - D7   : digital output data pins. D4 is LSB
      OUTDAT    : digital output pin for OUTDAT signal
*/
int i = 0;

void setup() 
{
  pinMode(3, OUTPUT); // D0
  pinMode(4, OUTPUT); // D1
  pinMode(5, OUTPUT); // D2
  pinMode(6, OUTPUT); // D3
  pinMode(7, OUTPUT); // D4
  pinMode(8, OUTPUT); // D5
  pinMode(9, OUTPUT); // D6
  pinMode(10, OUTPUT);// D7

  pinMode(2, OUTPUT); // OUTDAT
  digitalWrite(2, LOW); 
}

void loop() 
{
  for (i = 0; i< 10; i++)
  {
    // Set up Data.
    switch (i)
    {
      case 0: 
        digitalWrite(3, LOW);
        digitalWrite(4, LOW);
        digitalWrite(5, LOW);
        digitalWrite(6, LOW);
        digitalWrite(7, LOW);
        digitalWrite(8, LOW);
        digitalWrite(9, LOW);
        digitalWrite(10, LOW);
        break;
      case 1:
        digitalWrite(3, HIGH);
        digitalWrite(4, LOW);
        digitalWrite(5, LOW);
        digitalWrite(6, LOW);
        digitalWrite(7, HIGH);
        digitalWrite(8, LOW);
        digitalWrite(9, LOW);
        digitalWrite(10, LOW);
        break;
      case 2:
        digitalWrite(3, LOW);
        digitalWrite(4, HIGH);
        digitalWrite(5, LOW);
        digitalWrite(6, LOW);
        digitalWrite(7, LOW);
        digitalWrite(8, HIGH);
        digitalWrite(9, LOW);
        digitalWrite(10, LOW);
        break;
      case 3:
        digitalWrite(3, HIGH);
        digitalWrite(4, HIGH);
        digitalWrite(5, LOW);
        digitalWrite(6, LOW);
        digitalWrite(7, HIGH);
        digitalWrite(8, HIGH);
        digitalWrite(9, LOW);
        digitalWrite(10, LOW);
        break;
      case 4:
        digitalWrite(3, LOW);
        digitalWrite(4, LOW);
        digitalWrite(5, HIGH);
        digitalWrite(6, LOW);
        digitalWrite(7, LOW);
        digitalWrite(8, LOW);
        digitalWrite(9, HIGH);
        digitalWrite(10, LOW);
        break;
      case 5:
        digitalWrite(3, HIGH);
        digitalWrite(4, LOW);
        digitalWrite(5, HIGH);
        digitalWrite(6, LOW);
        digitalWrite(7, HIGH);
        digitalWrite(8, LOW);
        digitalWrite(9, HIGH);
        digitalWrite(10, LOW);
        break;
      case 6:
        digitalWrite(3, LOW);
        digitalWrite(4, HIGH);
        digitalWrite(5, HIGH);
        digitalWrite(6, LOW);
        digitalWrite(7, LOW);
        digitalWrite(8, HIGH);
        digitalWrite(9, HIGH);
        digitalWrite(10, LOW);
        break;
      case 7:
        digitalWrite(3, HIGH);
        digitalWrite(4, HIGH);
        digitalWrite(5, HIGH);
        digitalWrite(6, LOW);
        digitalWrite(7, HIGH);
        digitalWrite(8, HIGH);
        digitalWrite(9, HIGH);
        digitalWrite(10, LOW);
        break;
      case 8:
        digitalWrite(3, LOW);
        digitalWrite(4, LOW);
        digitalWrite(5, LOW);
        digitalWrite(6, HIGH);
        digitalWrite(7, LOW);
        digitalWrite(8, LOW);
        digitalWrite(9, LOW);
        digitalWrite(10, HIGH);
        break;
      case 9:
        digitalWrite(3, HIGH);
        digitalWrite(4, LOW);
        digitalWrite(5, LOW);
        digitalWrite(6, HIGH);
        digitalWrite(7, HIGH);
        digitalWrite(8, LOW);
        digitalWrite(9, LOW);
        digitalWrite(10, HIGH);
        break;
      default:
        digitalWrite(3, HIGH);
        digitalWrite(4, HIGH);
        digitalWrite(5, HIGH);
        digitalWrite(6, HIGH);
        digitalWrite(7, HIGH);
        digitalWrite(8, HIGH);
        digitalWrite(9, HIGH);
        digitalWrite(10, HIGH);
        break;
    }

    // Pulse OUTDAT.
    digitalWrite(2, HIGH); 
    digitalWrite(2, LOW); 
    delay (1000);
  }
}
