bglasford1/AgcBlockIIComputer/(commit log)

2021-07-12 Added assembler output files
2021-07-12 Added assembled Test files.
2021-08-23 Minor tweaks.
    [DISP.sch, DISP_DMI.sch, DISP_MON.sch, DISP_MON_DCD.sch, DISP_MON_LED.sch, DISP_MON_SWT.sch]
2021-08-23 Initial commit.
    [DSKY-DSP-CHN.sch, DSKY-DSP.sch, DSKY-IMI.sch, DSKY-KBD.sch, DSKY.sch, DSKY_DSP_DCC.sch, DSKY_DSP_DCD1.sch, DSKY_DSP_DCD2_3.sch]
2021-09-05 Initial Upload
    [MEM_ADR_MDE.sch, MEM.sch, MEM_ADR.sch, MEM_ADR_ATS.sch, MEM_ADR_BNK.sch, MEM_ADR_CTL.sch, MEM_ADR_S.sch, MEM_CTR.sch]
2021-09-07 Minor tweaks to the display decoding logic.
    [DSKY-DSP-CHN.sch, DSKY-DSP.sch, DSKY-IMI.sch, DSKY-KBD.sch, DSKY.sch, DSKY_DSP_DCC.sch, DSKY_DSP_DCD1.sch, DSKY_DSP_DCD2_3.sch]
2021-09-22 Simplified reset lines.
    [DSKY-DSP-CHN.sch, DSKY-DSP.sch, DSKY-IMI.sch, DSKY-KBD.sch, DSKY.sch, DSKY_DSP_IND.sch]
2021-09-23 Cleaned up clock logic.
    [DSKY-DSP-CHN.sch, DSKY-DSP.sch, DSKY-KBD.sch, DSKY_DSP_DCD1.sch]
2021-09-27 Sign processing overhauled.
    [DSKY-DSP-CHN.sch, DSKY-DSP-SIGN.sch, DSKY-DSP.sch, DSKY-IMI.sch, DSKY-KBD.sch, DSKY.sch, DSKY_DSP_DCC.sch, DSKY_DSP_DCD1.sch]
2021-09-30 Overhauled the handling of the sign characters.
    [DSKY-DSP-CHN.sch, DSKY-DSP-SIGN.sch, DSKY-DSP.sch, DSKY-IMI.sch, DSKY-KBD.sch, DSKY.sch, DSKY_DSP_DCD1.sch, DSKY_DSP_DCD2_3.sch]
2021-10-21 Minor tweaks during implementation.
    [DSKY-DSP-SIGN.sch, DSKY_DSP_DCD1.sch, DSKY_DSP_DCD2_3.sch]
2021-10-21 Added DSKY_DSP_SIGN schematic
2021-10-25 Final tweaks, the DSKY is now complete!
    [DSKY-DSP-SIGN.sch, DSKY-DSP.sch, DSKY-IMI.sch, DSKY.sch, DSKY_DSP_DCD1.sch, DSKY_DSP_DCD2_3.sch]
2021-11-02 Added DSKY test schematic
    [DSKY-DSP-CHN.sch, DSKY-DSP-SIGN.sch, DSKY-DSP.sch, DSKY-IMI.sch, DSKY-KBD.sch, DSKY-TEST.sch, DSKY.sch, DSKY_DSP_DCC.sch]
2021-11-16 DSKY Redesign
    [DSKY-DSP-CHN.sch, DSKY-DSP.sch, DSKY-IMI.sch, DSKY-KBD.sch, DSKY-TEST.sch, DSKY.sch, DSKY_DSP_DCC.sch, DSKY_DSP_DLD.sch]
2021-11-29 Minor DSKY tweaks.
    [DSKY-DSP-TEST.sch, DSKY-DSP.sch, DSKY-IMI.sch, DSKY-KBD-TEST.sch, DSKY.sch, DSKY_DSP_DLD.sch, DSKY_DSP_LCD.sch, DSKY_DSP_SGN.sch]
2021-12-21 Using 4 LED driver chips.
    [DSKY-DSP-CHN.sch, DSKY-DSP-SIGN.sch, DSKY-DSP.sch, DSKY-IMI.sch, DSKY-KBD.sch, DSKY-TEST.sch, DSKY.sch, DSKY_DSP_CTL.sch]
2022-01-16 New Display Logic Using ICM7128s
    [DSKY_DSP_CTL.sch]
2022-04-18 Modified to use fourth display decoder chip.
    [DSKY-DSP-CHN.sch, DSKY-DSP-REGCTL.sch, DSKY-DSP-SIGN.sch, DSKY-DSP.sch, DSKY-IMI.sch, DSKY-KBD.sch, DSKY-TEST.sch, DSKY.sch]
2022-04-18 Minor tweaks
    [MEM.sch, MEM_ADR.sch, MEM_ADR_CTL.sch, MEM_INT.sch, MEM_MBF_GMB.sch, MEM_MMI.sch]
2022-07-07 Initial version
    [CTL.sch, CTL_CLK.sch, CTL_CMI.sch, CTL_CPM-A.sch, CTL_CPM-B.sch, CTL_CPM-C.sch, CTL_SCL.sch, CTL_SEQ.sch]
