bglasford1/AgcBlockIIComputer/(notices)

Notices in the files:
AGCSimulator/src/SubseqDecoderGen.java:
and/or modify it under the terms of the GNU General Public License as
published by the Free Software Foundation; either version 3 of the License,
or any later version. This software is distributed without any warranty
YUL/yaYUL.h:
yaAGC is free software; you can redistribute it and/or modify
it under the terms of the GNU General Public License as published by
the Free Software Foundation; either version 2 of the License, or
(at your option) any later version.
